hamarituc/poly880-ng/original/schaltung/addr.kicad_sch

## KiCad design original/schaltung/addr.kicad_sch (2026-01-04)

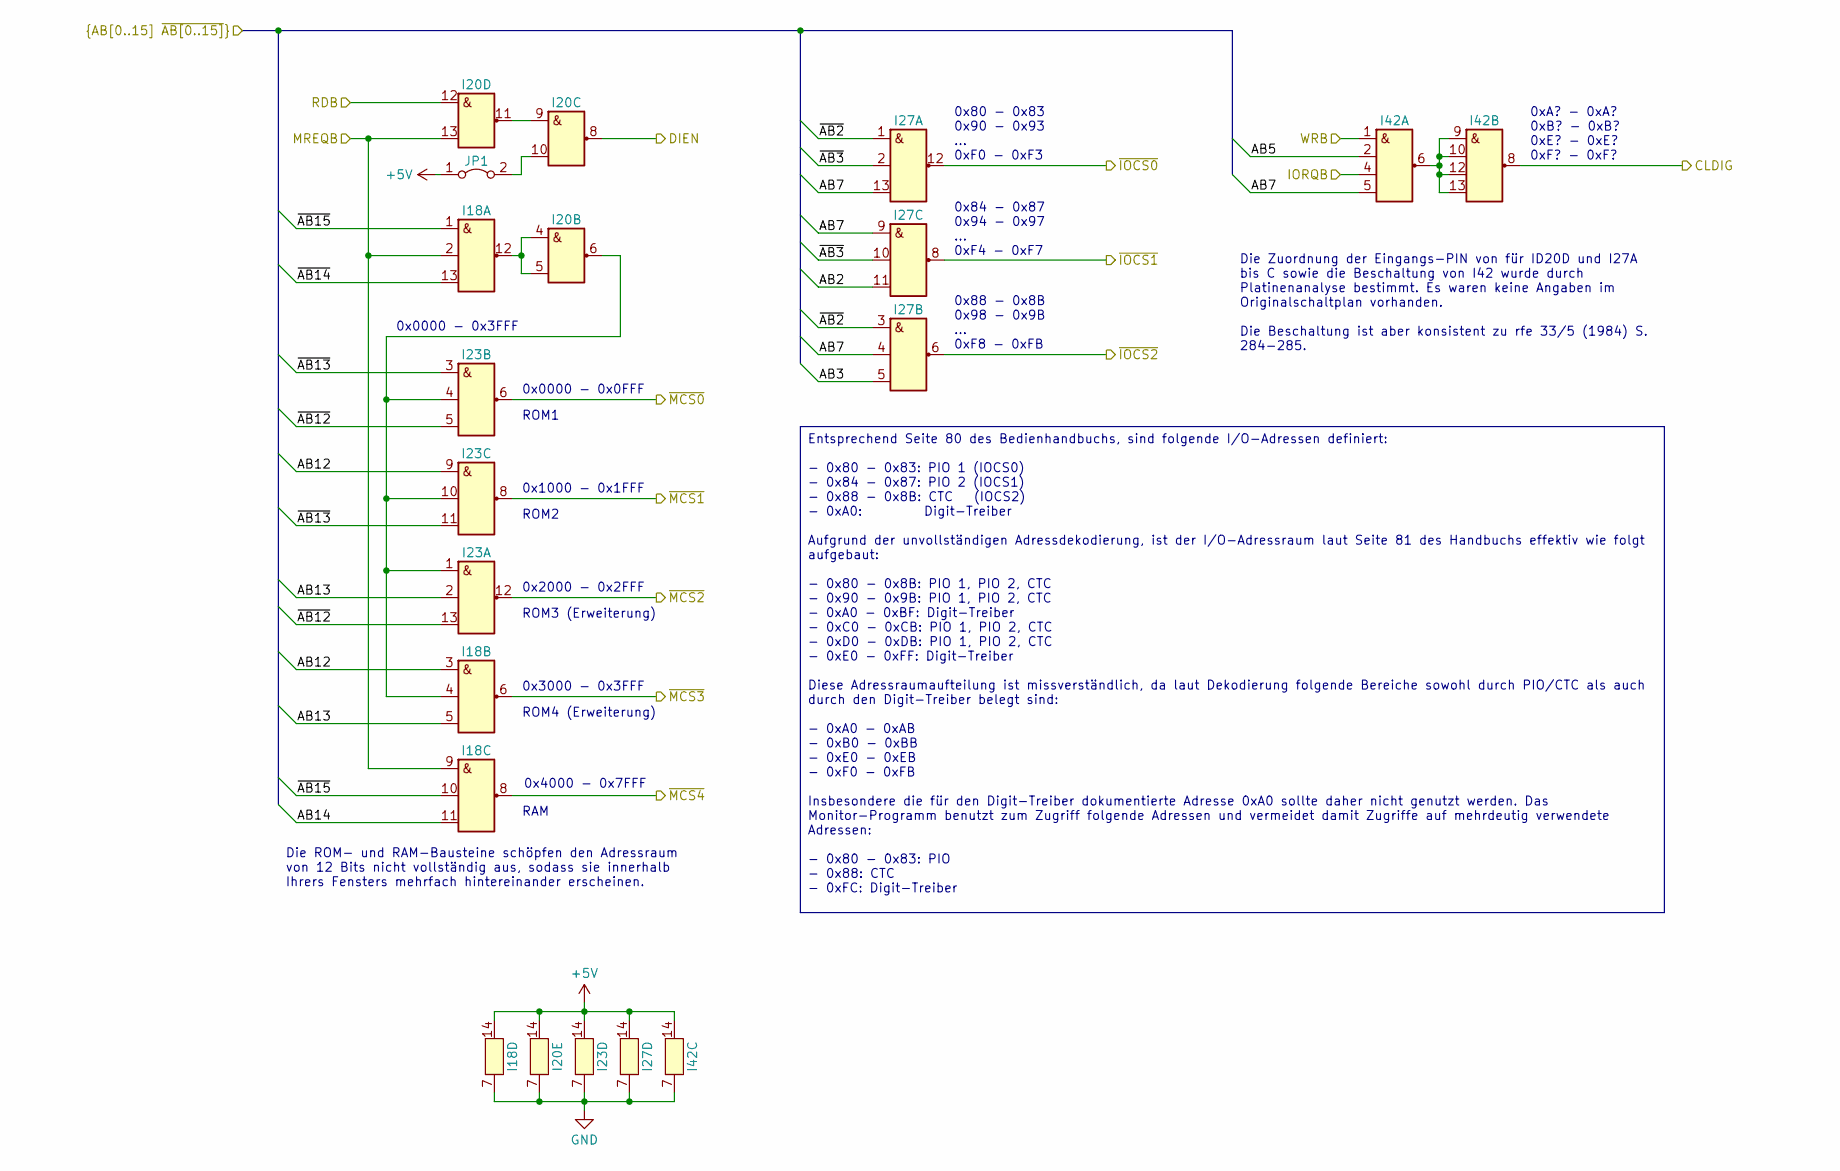
[picture p1: schematic addr.kicad_sch]

Parts:
I18, I23, I27: D110D
I20: D100D
I42: D120D
JP1: Jumper_2_Bridged

Connections:
+5V: I18.14 (Vcc), I20.14 (Vcc), I23.14 (Vcc), I27.14 (Vcc), I42.14 (Vcc), JP1.1 (A)
AB2: I27.11 (C3)
AB3: I27.5 (C2)
AB5: I42.2 (B1)
AB7: I27.4 (B2), I27.9 (A3), I27.13 (C1), I42.5 (D1)
AB12: I18.3 (A2), I23.9 (A3)
AB13: I18.5 (C2), I23.2 (B1)
AB14: I18.11 (C3)
CLDIG: I42.8 (Y2)
DIEN: I20.8 (Y3)
GND: I18.7 (GND), I20.7 (GND), I23.7 (GND), I27.7 (GND), I42.7 (GND)
IORQB: I42.4 (C1)
MREQB: I18.2 (B1), I18.9 (A3), I20.13 (B4)
unnamed: I18.4 (B2), I20.6 (Y2), I23.1 (A1), I23.4 (B2), I23.10 (B3)
unnamed: I18.12 (Y1), I20.4 (A2), I20.5 (B2)
unnamed: I20.10 (B3), JP1.2 (B)
unnamed: I20.9 (A3), I20.11 (Y4)
unnamed: I42.6 (Y1), I42.9 (A2), I42.10 (B2), I42.12 (C2), I42.13 (D2)
RDB: I20.12 (A4)
WRB: I42.1 (A1)
~AB2: I27.1 (A1), I27.3 (A2)
~AB3: I27.2 (B1), I27.10 (B3)
~AB12: I23.5 (C2), I23.13 (C1)
~AB13: I23.3 (A2), I23.11 (C3)
~AB14: I18.13 (C1)
~AB15: I18.1 (A1), I18.10 (B3)
~IOCS0: I27.12 (Y1)
~IOCS1: I27.8 (Y3)
~IOCS2: I27.6 (Y2)
~MCS0: I23.6 (Y2)
~MCS1: I23.8 (Y3)
~MCS2: I23.12 (Y1)
~MCS3: I18.6 (Y2)
~MCS4: I18.8 (Y3)

Notes on the sheet:
0x0000 - 0x3FFF
0x0000 - 0x0FFF
ROM4 (Erweiterung)
0x84 - 0x87 0x94 - 0x97 ... 0xF4 - 0xF7
0x2000 - 0x2FFF
0x1000 - 0x1FFF
ROM1
0x3000 - 0x3FFF
RAM
ROM3 (Erweiterung)
0xA? - 0xA? 0xB? - 0xB? 0xE? - 0xE? 0xF? - 0xF?
0x80 - 0x83 0x90 - 0x93 ... 0xF0 - 0xF3
0x88 - 0x8B 0x98 - 0x9B ... 0xF8 - 0xFB
ROM2
0x4000 - 0x7FFF
Die Zuordnung der Eingangs-PIN von für ID20D und I27A bis C sowie die Beschaltung von I42 wurde durch Platinenanalyse bestimmt. Es waren keine Angaben im Originalschaltplan vorhanden. Die Beschaltung ist aber konsistent zu rfe 33/5 (1984) S. 284-285.
Entsprechend Seite 80 des Bedienhandbuchs, sind folgende I/O-Adressen definiert: - 0x80 - 0x83: PIO 1 (IOCS0) - 0x84 - 0x87: PIO 2 (IOCS1) - 0x88 - 0x8B: CTC (IOCS2) - 0xA0: Digit-Treiber Aufgrund der unvollständigen Adressdekodierung, ist der I/O-Adressraum laut Seite 81 des Handbuchs effektiv wie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
Die ROM- und RAM-Bausteine schöpfen den Adressraum von 12 Bits nicht vollständig aus, sodass sie innerhalb Ihrers Fensters mehrfach hintereinander erscheinen.
