hamarituc/poly880-ng/original/schaltung/bus.kicad_sch

## KiCad design original/schaltung/bus.kicad_sch (2026-01-04)

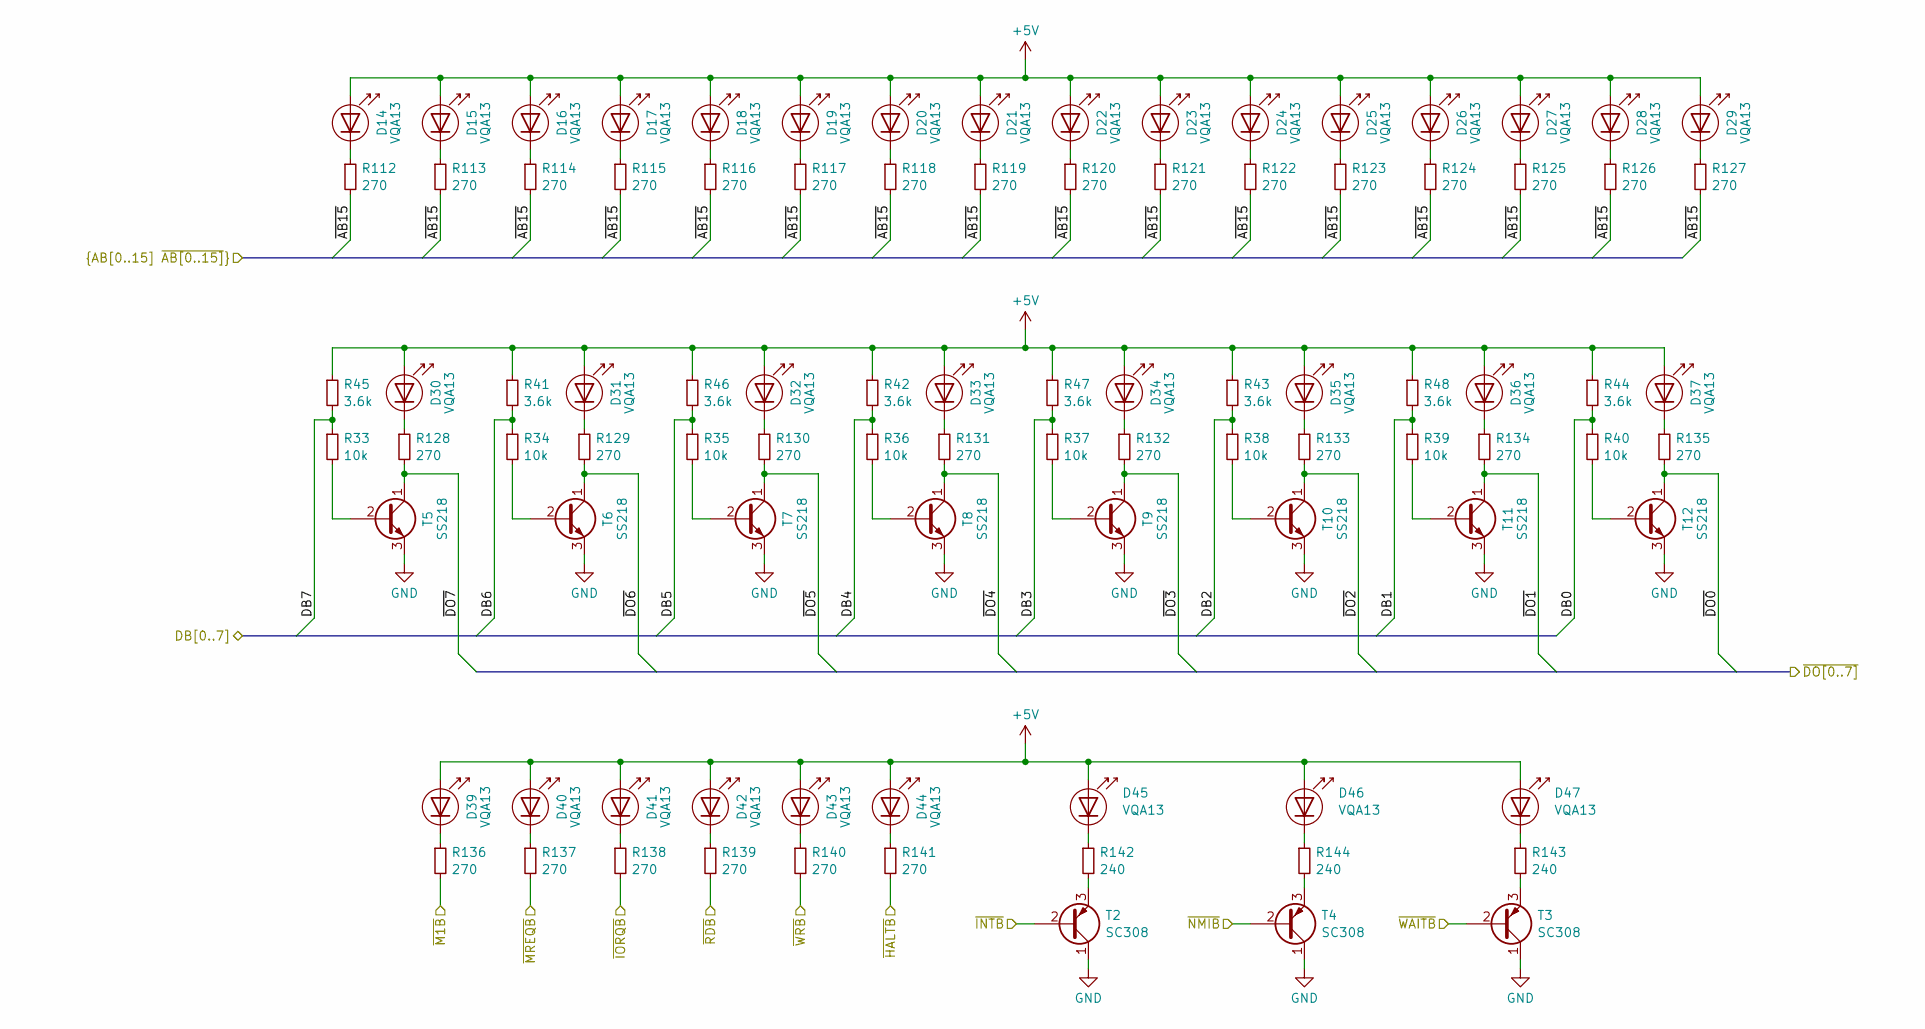
[picture p2: schematic bus.kicad_sch]

Parts:
D14, D15, D16, D17, D18, D19, D20, D21, D22, D23, D24, D25, D26, D27, D28, D29, D30, D31, D32, D33, D34, D35, D36, D37, D39, D40, D41, D42, D43, D44, D45, D46, D47: VQA13
R33, R34, R35, R36, R37, R38, R39, R40: 10k
R41, R42, R43, R44, R45, R46, R47, R48: 3.6k
R112, R113, R114, R115, R116, R117, R118, R119, R120, R121, R122, R123, R124, R125, R126, R127, R128, R129, R130, R131, R132, R133, R134, R135, R136, R137, R138, R139, R140, R141: 270
R142, R143, R144: 240
T2, T3, T4: SC308; T_E-Line_P2.5mm_Vertical
T5, T6, T7, T8, T9, T10, T11, T12: SS218; T_E-Line_P2.5mm_Vertical

Connections:
+5V: D14.2 (A), D15.2 (A), D16.2 (A), D17.2 (A), D18.2 (A), D19.2 (A), D20.2 (A), D21.2 (A), D22.2 (A), D23.2 (A), D24.2 (A), D25.2 (A), D26.2 (A), D27.2 (A), D28.2 (A), D29.2 (A), D30.2 (A), D31.2 (A), D32.2 (A), D33.2 (A), D34.2 (A), D35.2 (A), D36.2 (A), D37.2 (A), D39.2 (A), D40.2 (A), D41.2 (A), D42.2 (A), D43.2 (A), D44.2 (A), D45.2 (A), D46.2 (A), D47.2 (A), R41.1, R42.1, R43.1, R44.1, R45.1, R46.1, R47.1, R48.1
DB0: R40.1, R44.2
DB1: R39.1, R48.2
DB2: R38.1, R43.2
DB3: R37.1, R47.2
DB4: R36.1, R42.2
DB5: R35.1, R46.2
DB6: R34.1, R41.2
DB7: R33.1, R45.2
GND: T2.1 (C), T3.1 (C), T4.1 (C), T5.3 (E), T6.3 (E), T7.3 (E), T8.3 (E), T9.3 (E), T10.3 (E), T11.3 (E), T12.3 (E)
unnamed: D14.1 (K), R112.1
unnamed: D15.1 (K), R113.1
unnamed: D16.1 (K), R114.1
unnamed: D17.1 (K), R115.1
unnamed: D18.1 (K), R116.1
unnamed: D19.1 (K), R117.1
unnamed: D20.1 (K), R118.1
unnamed: D21.1 (K), R119.1
unnamed: D22.1 (K), R120.1
unnamed: D23.1 (K), R121.1
unnamed: D24.1 (K), R122.1
unnamed: D25.1 (K), R123.1
unnamed: D26.1 (K), R124.1
unnamed: D27.1 (K), R125.1
unnamed: D28.1 (K), R126.1
unnamed: D29.1 (K), R127.1
unnamed: D30.1 (K), R128.1
unnamed: D31.1 (K), R129.1
unnamed: D32.1 (K), R130.1
unnamed: D33.1 (K), R131.1
unnamed: D34.1 (K), R132.1
unnamed: D35.1 (K), R133.1
unnamed: D36.1 (K), R134.1
unnamed: D37.1 (K), R135.1
unnamed: D39.1 (K), R136.1
unnamed: D40.1 (K), R137.1
unnamed: D41.1 (K), R138.1
unnamed: D42.1 (K), R139.1
unnamed: D43.1 (K), R140.1
unnamed: D44.1 (K), R141.1
unnamed: D45.1 (K), R142.1
unnamed: D46.1 (K), R144.1
unnamed: D47.1 (K), R143.1
unnamed: R33.2, T5.2 (B)
unnamed: R34.2, T6.2 (B)
unnamed: R35.2, T7.2 (B)
unnamed: R36.2, T8.2 (B)
unnamed: R37.2, T9.2 (B)
unnamed: R38.2, T10.2 (B)
unnamed: R39.2, T11.2 (B)
unnamed: R40.2, T12.2 (B)
unnamed: R142.2, T2.3 (E)
unnamed: R143.2, T3.3 (E)
unnamed: R144.2, T4.3 (E)
~AB15: R112.2, R113.2, R114.2, R115.2, R116.2, R117.2, R118.2, R119.2, R120.2, R121.2, R122.2, R123.2, R124.2, R125.2, R126.2, R127.2
~DO0: R135.2, T12.1 (C)
~DO1: R134.2, T11.1 (C)
~DO2: R133.2, T10.1 (C)
~DO3: R132.2, T9.1 (C)
~DO4: R131.2, T8.1 (C)
~DO5: R130.2, T7.1 (C)
~DO6: R129.2, T6.1 (C)
~DO7: R128.2, T5.1 (C)
~HALTB: R141.2
~INTB: T2.2 (B)
~IORQB: R138.2
~M1B: R136.2
~MREQB: R137.2
~NMIB: T4.2 (B)
~RDB: R139.2
~WAITB: T3.2 (B)
~WRB: R140.2
