hamarituc/poly880-ng/original/schaltung/clock.kicad_sch

## KiCad design original/schaltung/clock.kicad_sch (2026-01-04)

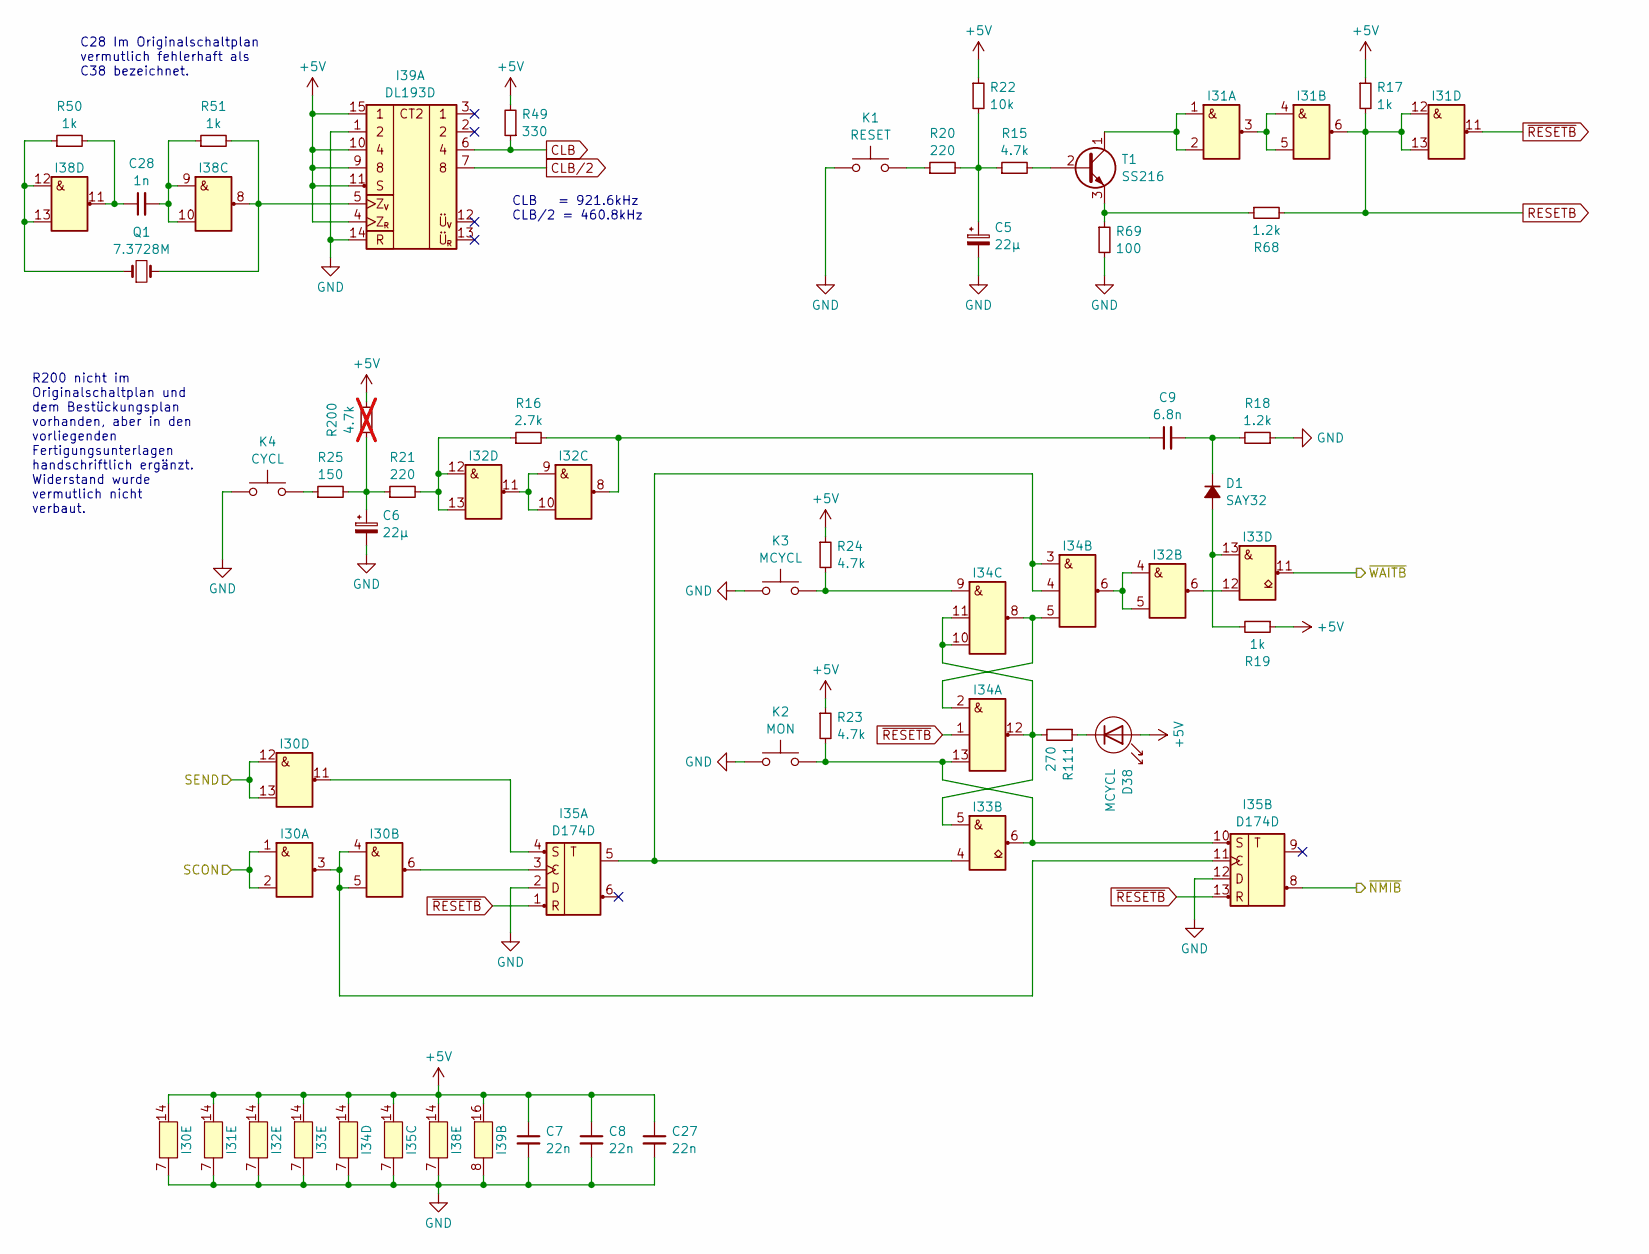
[picture p3: schematic clock.kicad_sch]

Parts:
C5, C6: 22µ
C7, C8, C27: 22n
C9: 6.8n
C28: 1n
D1: SAY32; D_E-Line_01x02_P2.5mm_Vertical_KA
D38: MCYCL
I30, I31, I32, I38: D100D
I33: D103D
I34: D110D
I35: D174D
I39: DL193D
K1: RESET
K2: MON
K3: MCYCL
K4: CYCL
Q1: 7.3728M
R15, R23, R24: 4.7k
R16: 2.7k
R17, R19, R50, R51: 1k
R18, R68: 1.2k
R20, R21: 220
R22: 10k
R25: 150
R49: 330
R69: 100
R111: 270
R200: 4.7k; not fitted
T1: SS216; T_E-Line_P2.5mm_Vertical

Connections:
+5V: C7.1, C8.1, C27.1, D38.2 (A), I30.14 (Vcc), I31.14 (Vcc), I32.14 (Vcc), I33.14 (Vcc), I34.14 (Vcc), I35.14 (Vcc), I38.14 (Vcc), I39.4 (TR), I39.9 (D), I39.10 (C), I39.11 (S), I39.15 (A), I39.16 (Vcc), R17.1, R19.1, R22.1, R23.1, R24.1, R49.2, R200.2
CLB: I39.6 (QC), R49.1
CLB/2: I39.7 (QD)
GND: C5.2, C6.2, C7.2, C8.2, C27.2, I30.7 (GND), I31.7 (GND), I32.7 (GND), I33.7 (GND), I34.7 (GND), I35.2 (D1), I35.7 (GND), I35.12 (D2), I38.7 (GND), I39.1 (B), I39.8 (GND), I39.14 (R), K1.1, K2.1, K3.1, K4.1, R18.1, R69.2
unnamed: C5.1, R15.1, R20.2, R22.2
unnamed: C6.1, R21.1, R25.2, R200.1
unnamed: C9.1, I32.8 (Y3), R16.2
unnamed: C9.2, D1.1 (K), R18.2
unnamed: C28.1, I38.11 (Y4), R50.2
unnamed: C28.2, I38.9 (A3), I38.10 (B3), R51.1
unnamed: D1.2 (A), I33.13 (B4), R19.2
unnamed: D38.1 (K), R111.1
unnamed: I30.3 (Y1), I30.4 (A2), I30.5 (B2), I35.11 (T2)
unnamed: I30.6 (Y2), I35.3 (T1)
unnamed: I30.11 (Y4), I35.4 (S1)
unnamed: I31.1 (A1), I31.2 (B1), T1.1 (C)
unnamed: I31.3 (Y1), I31.4 (A2), I31.5 (B2)
unnamed: I32.4 (A2), I32.5 (B2), I34.6 (Y2)
unnamed: I32.6 (Y2), I33.12 (A4)
unnamed: I32.9 (A3), I32.10 (B3), I32.11 (Y4)
unnamed: I32.12 (A4), I32.13 (B4), R16.1, R21.2
unnamed: I33.4 (A2), I34.3 (A2), I34.4 (B2), I35.5 (Q1)
unnamed: I33.5 (B2), I34.10 (B3), I34.11 (C3), I34.12 (Y1), R111.2
unnamed: I33.6 (Y2), I34.13 (C1), I35.10 (S2), K2.2, R23.2
unnamed: I34.2 (B1), I34.5 (C2), I34.8 (Y3)
unnamed: I34.9 (A3), K3.2, R24.2
unnamed: I38.8 (Y3), I39.5 (TV), Q1.2, R51.2
unnamed: I38.12 (A4), I38.13 (B4), Q1.1, R50.1
unnamed: K1.2, R20.1
unnamed: K4.2, R25.1
unnamed: R15.2, T1.2 (B)
unnamed: R68.1, R69.1, T1.3 (E)
RESETB: I31.6 (Y2), I31.12 (A4), I31.13 (B4), R17.2, R68.2
SCON: I30.1 (A1), I30.2 (B1)
SEND: I30.12 (A4), I30.13 (B4)
~NMIB: I35.8 (/Q2)
~RESETB: I31.11 (Y4), I34.1 (A1), I35.1 (R1), I35.13 (R2)
~WAITB: I33.11 (Y4)

Notes on the sheet:
C28 Im Originalschaltplan vermutlich fehlerhaft als C38 bezeichnet.
CLB = 921.6kHz CLB/2 = 460.8kHz
R200 nicht im Originalschaltplan und dem Bestückungsplan vorhanden, aber in den vorliegenden Fertigungsunterlagen handschriftlich ergänzt. Widerstand wurde vermutlich nicht verbaut.
