hamarituc/poly880-ng/original/schaltung/cpu.kicad_sch

## KiCad design original/schaltung/cpu.kicad_sch (2026-01-04)

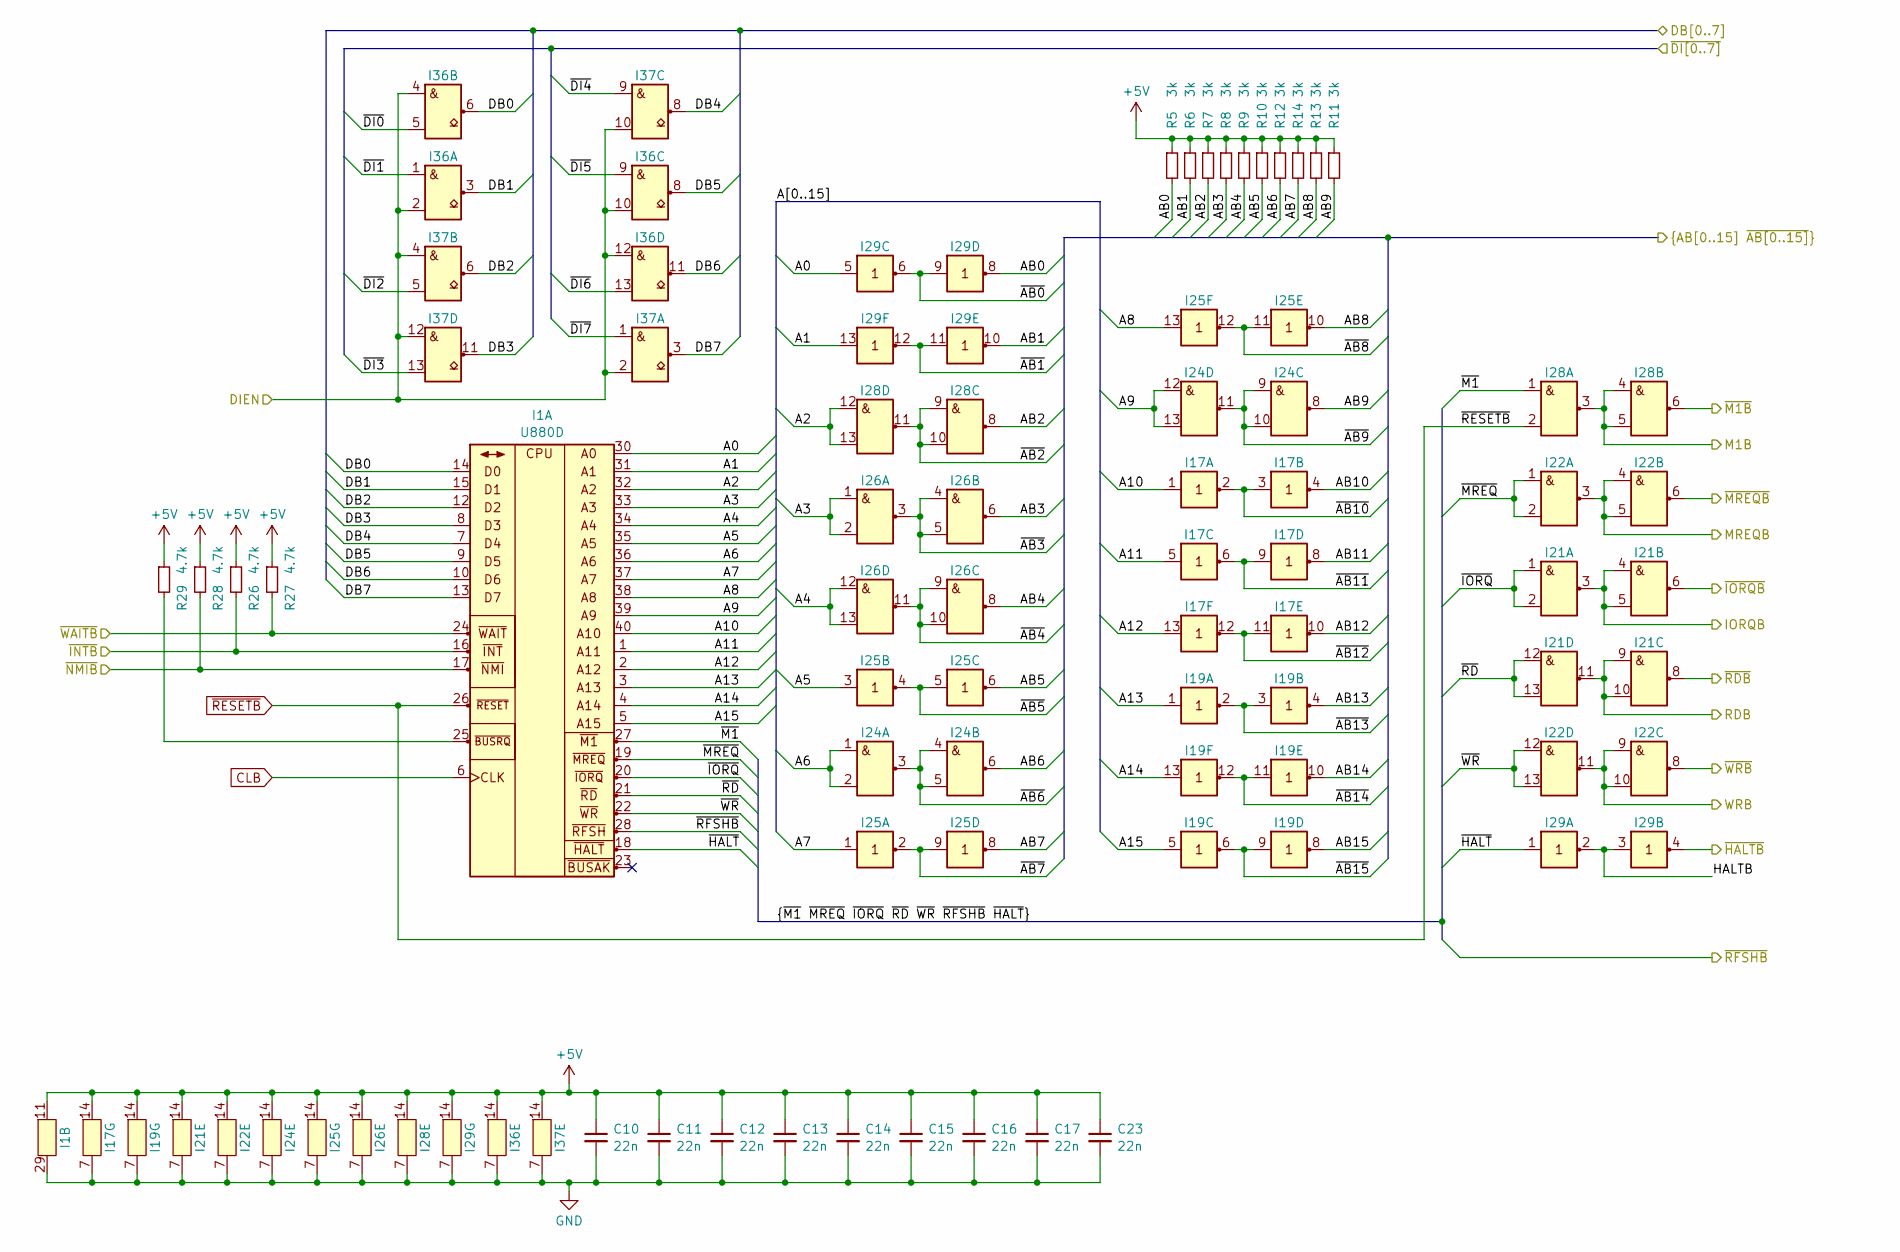
[picture p4: schematic cpu.kicad_sch]

Parts:
C10, C11, C12, C13, C14, C15, C16, C17, C23: 22n
I1: U880D
I17, I19, I25, I29: D104D
I21, I22, I24, I26, I28: D100D
I36, I37: D103D
R5, R6, R7, R8, R9, R10, R11, R12, R13, R14: 3k
R26, R27, R28, R29: 4.7k

Connections:
+5V: C10.1, C11.1, C12.1, C13.1, C14.1, C15.1, C16.1, C17.1, C23.1, I1.11 (Vcc), I17.14 (Vcc), I19.14 (Vcc), I21.14 (Vcc), I22.14 (Vcc), I24.14 (Vcc), I25.14 (Vcc), I26.14 (Vcc), I28.14 (Vcc), I29.14 (Vcc), I36.14 (Vcc), I37.14 (Vcc), R5.1, R6.1, R7.1, R8.1, R9.1, R10.1, R11.1, R12.1, R13.1, R14.1, R26.1, R27.1, R28.1, R29.1
A0: I1.30 (A0), I29.5 (A3)
A1: I1.31 (A1), I29.13 (A6)
A2: I1.32 (A2), I28.12 (A4), I28.13 (B4)
A3: I1.33 (A3), I26.1 (A1), I26.2 (B1)
A4: I1.34 (A4), I26.12 (A4), I26.13 (B4)
A5: I1.35 (A5), I25.3 (A2)
A6: I1.36 (A6), I24.1 (A1), I24.2 (B1)
A7: I1.37 (A7), I25.1 (A1)
A8: I1.38 (A8), I25.13 (A6)
A9: I1.39 (A9), I24.12 (A4), I24.13 (B4)
A10: I1.40 (A10), I17.1 (A1)
A11: I1.1 (A11), I17.5 (A3)
A12: I1.2 (A12), I17.13 (A6)
A13: I1.3 (A13), I19.1 (A1)
A14: I1.4 (A14), I19.13 (A6)
A15: I1.5 (A15), I19.5 (A3)
AB0: I29.8 (Y4), R5.2
AB1: I29.10 (Y5), R6.2
AB2: I28.8 (Y3), R7.2
AB3: I26.6 (Y2), R8.2
AB4: I26.8 (Y3), R9.2
AB5: I25.6 (Y3), R10.2
AB6: I24.6 (Y2), R12.2
AB7: I25.8 (Y4), R14.2
AB8: I25.10 (Y5), R13.2
AB9: I24.8 (Y3), R11.2
AB10: I17.4 (Y2)
AB11: I17.8 (Y4)
AB12: I17.10 (Y5)
AB13: I19.4 (Y2)
AB14: I19.10 (Y5)
AB15: I19.8 (Y4)
CLB: I1.6 (CLK)
DB0: I1.14 (D0), I36.6 (Y2)
DB1: I1.15 (D1), I36.3 (Y1)
DB2: I1.12 (D2), I37.6 (Y2)
DB3: I1.8 (D3), I37.11 (Y4)
DB4: I1.7 (D4), I37.8 (Y3)
DB5: I1.9 (D5), I36.8 (Y3)
DB6: I1.10 (D6), I36.11 (Y4)
DB7: I1.13 (D7), I37.3 (Y1)
DIEN: I36.2 (B1), I36.4 (A2), I36.10 (B3), I36.12 (A4), I37.2 (B1), I37.4 (A2), I37.10 (B3), I37.12 (A4)
GND: C10.2, C11.2, C12.2, C13.2, C14.2, C15.2, C16.2, C17.2, C23.2, I1.29 (GND), I17.7 (GND), I19.7 (GND), I21.7 (GND), I22.7 (GND), I24.7 (GND), I25.7 (GND), I26.7 (GND), I28.7 (GND), I29.7 (GND), I36.7 (GND), I37.7 (GND)
HALTB: I29.2 (Y1), I29.3 (A2)
IORQB: I21.3 (Y1), I21.4 (A2), I21.5 (B2)
M1B: I28.3 (Y1), I28.4 (A2), I28.5 (B2)
MREQB: I22.3 (Y1), I22.4 (A2), I22.5 (B2)
unnamed: I1.25 (~BUSRQ), R29.2
RDB: I21.9 (A3), I21.10 (B3), I21.11 (Y4)
WRB: I22.9 (A3), I22.10 (B3), I22.11 (Y4)
~AB0: I29.6 (Y3), I29.9 (A4)
~AB1: I29.11 (A5), I29.12 (Y6)
~AB2: I28.9 (A3), I28.10 (B3), I28.11 (Y4)
~AB3: I26.3 (Y1), I26.4 (A2), I26.5 (B2)
~AB4: I26.9 (A3), I26.10 (B3), I26.11 (Y4)
~AB5: I25.4 (Y2), I25.5 (A3)
~AB6: I24.3 (Y1), I24.4 (A2), I24.5 (B2)
~AB7: I25.2 (Y1), I25.9 (A4)
~AB8: I25.11 (A5), I25.12 (Y6)
~AB9: I24.9 (A3), I24.10 (B3), I24.11 (Y4)
~AB10: I17.2 (Y1), I17.3 (A2)
~AB11: I17.6 (Y3), I17.9 (A4)
~AB12: I17.11 (A5), I17.12 (Y6)
~AB13: I19.2 (Y1), I19.3 (A2)
~AB14: I19.11 (A5), I19.12 (Y6)
~AB15: I19.6 (Y3), I19.9 (A4)
~DI0: I36.5 (B2)
~DI1: I36.1 (A1)
~DI2: I37.5 (B2)
~DI3: I37.13 (B4)
~DI4: I37.9 (A3)
~DI5: I36.9 (A3)
~DI6: I36.13 (B4)
~DI7: I37.1 (A1)
~HALTB: I29.4 (Y2)
~HALT: I1.18 (~HALT), I29.1 (A1)
~INTB: I1.16 (~INT), R26.2
~IORQB: I21.6 (Y2)
~IORQ: I1.20 (~IORQ), I21.1 (A1), I21.2 (B1)
~M1B: I28.6 (Y2)
~M1: I1.27 (~M1), I28.1 (A1)
~MREQB: I22.6 (Y2)
~MREQ: I1.19 (~MREQ), I22.1 (A1), I22.2 (B1)
~NMIB: I1.17 (~NMI), R28.2
~RDB: I21.8 (Y3)
~RD: I1.21 (~RD), I21.12 (A4), I21.13 (B4)
~RESETB: I1.26 (~RESET), I28.2 (B1)
~RFSHB: I1.28 (~RFSH)
~WAITB: I1.24 (~WAIT), R27.2
~WRB: I22.8 (Y3)
~WR: I1.22 (~WR), I22.12 (A4), I22.13 (B4)
