hamarituc/poly880-ng/original/schaltung/disp.kicad_sch

## KiCad design original/schaltung/disp.kicad_sch (2026-01-04)

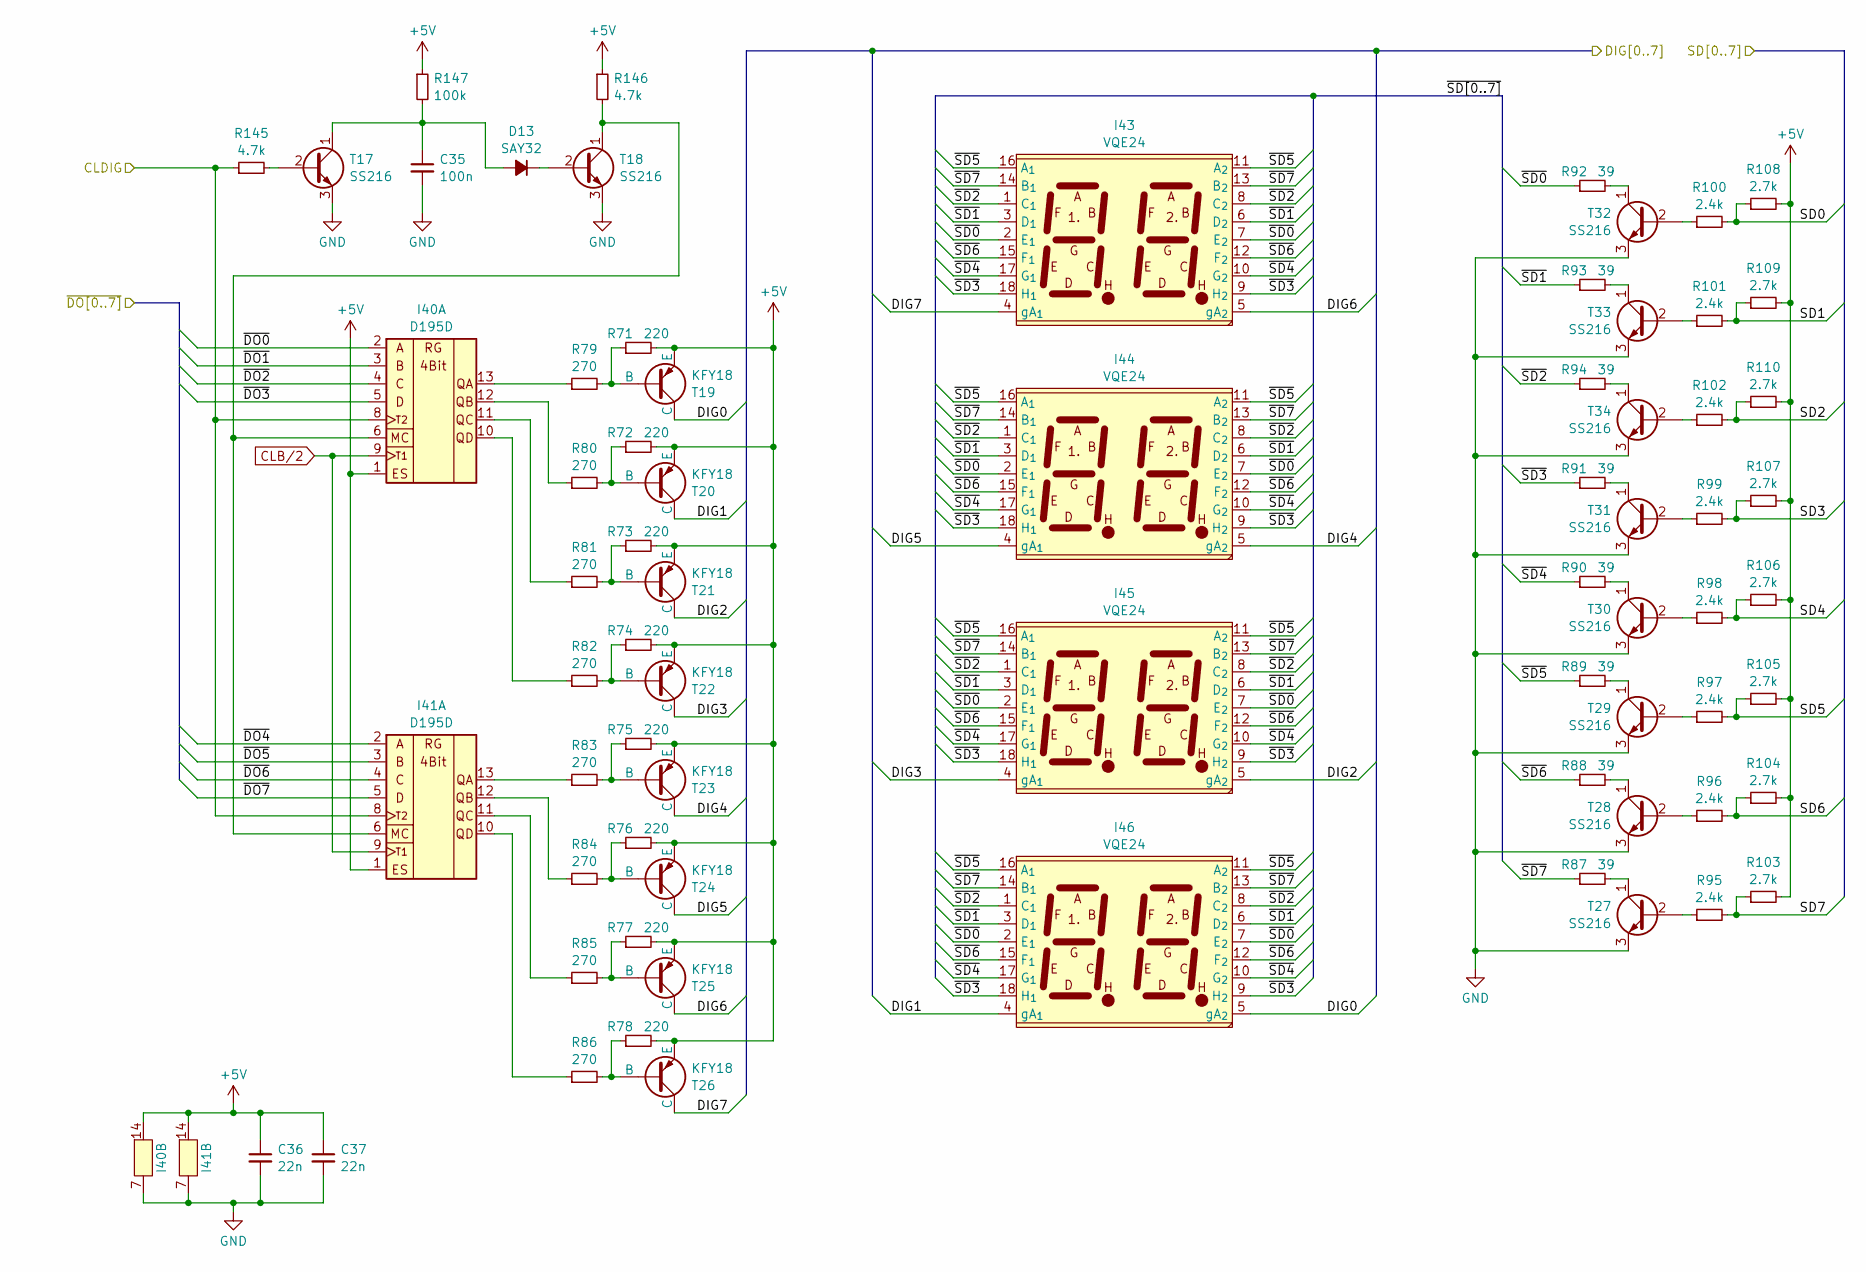
[picture p5: schematic disp.kicad_sch]

Parts:
C35: 100n
C36, C37: 22n
D13: SAY32; D_E-Line_01x02_P2.5mm_Vertical_KA
I40, I41: D195D
I43, I44, I45, I46: VQE24
R71, R72, R73, R74, R75, R76, R77, R78: 220
R79, R80, R81, R82, R83, R84, R85, R86: 270
R87, R88, R89, R90, R91, R92, R93, R94: 39
R95, R96, R97, R98, R99, R100, R101, R102: 2.4k
R103, R104, R105, R106, R107, R108, R109, R110: 2.7k
R145, R146: 4.7k
R147: 100k
T17, T18, T27, T28, T29, T30, T31, T32, T33, T34: SS216; T_E-Line_P2.5mm_Vertical
T19, T20, T21, T22, T23, T24, T25, T26: KFY18

Connections:
+5V: C36.1, C37.1, I40.1 (ES), I40.14 (Vcc), I41.1 (ES), I41.14 (Vcc), R71.2, R72.2, R73.2, R74.2, R75.2, R76.2, R77.2, R78.2, R103.2, R104.2, R105.2, R106.2, R107.2, R108.2, R109.2, R110.2, R146.1, R147.1, T19.3 (E), T20.3 (E), T21.3 (E), T22.3 (E), T23.3 (E), T24.3 (E), T25.3 (E), T26.3 (E)
CLB/2: I40.9 (T1), I41.9 (T1)
CLDIG: I40.8 (T2), I41.8 (T2), R145.1
DIG0: I46.5 (gA_{2}), T19.1 (C)
DIG1: I46.4 (gA_{1}), T20.1 (C)
DIG2: I45.5 (gA_{2}), T21.1 (C)
DIG3: I45.4 (gA_{1}), T22.1 (C)
DIG4: I44.5 (gA_{2}), T23.1 (C)
DIG5: I44.4 (gA_{1}), T24.1 (C)
DIG6: I43.5 (gA_{2}), T25.1 (C)
DIG7: I43.4 (gA_{1}), T26.1 (C)
GND: C35.2, C36.2, C37.2, I40.7 (GND), I41.7 (GND), T17.3 (E), T18.3 (E), T27.3 (E), T28.3 (E), T29.3 (E), T30.3 (E), T31.3 (E), T32.3 (E), T33.3 (E), T34.3 (E)
unnamed: C35.1, D13.2 (A), R147.2, T17.1 (C)
unnamed: D13.1 (K), T18.2 (B)
unnamed: I40.6 (MC), I41.6 (MC), R146.2, T18.1 (C)
unnamed: I40.10 (QD), R82.1
unnamed: I40.11 (QC), R81.1
unnamed: I40.12 (QB), R80.1
unnamed: I40.13 (QA), R79.1
unnamed: I41.10 (QD), R86.1
unnamed: I41.11 (QC), R85.1
unnamed: I41.12 (QB), R84.1
unnamed: I41.13 (QA), R83.1
unnamed: R71.1, R79.2, T19.2 (B)
unnamed: R72.1, R80.2, T20.2 (B)
unnamed: R73.1, R81.2, T21.2 (B)
unnamed: R74.1, R82.2, T22.2 (B)
unnamed: R75.1, R83.2, T23.2 (B)
unnamed: R76.1, R84.2, T24.2 (B)
unnamed: R77.1, R85.2, T25.2 (B)
unnamed: R78.1, R86.2, T26.2 (B)
unnamed: R87.2, T27.1 (C)
unnamed: R88.2, T28.1 (C)
unnamed: R89.2, T29.1 (C)
unnamed: R90.2, T30.1 (C)
unnamed: R91.2, T31.1 (C)
unnamed: R92.2, T32.1 (C)
unnamed: R93.2, T33.1 (C)
unnamed: R94.2, T34.1 (C)
unnamed: R95.1, T27.2 (B)
unnamed: R96.1, T28.2 (B)
unnamed: R97.1, T29.2 (B)
unnamed: R98.1, T30.2 (B)
unnamed: R99.1, T31.2 (B)
unnamed: R100.1, T32.2 (B)
unnamed: R101.1, T33.2 (B)
unnamed: R102.1, T34.2 (B)
unnamed: R145.2, T17.2 (B)
SD0: R100.2, R108.1
SD1: R101.2, R109.1
SD2: R102.2, R110.1
SD3: R99.2, R107.1
SD4: R98.2, R106.1
SD5: R97.2, R105.1
SD6: R96.2, R104.1
SD7: R95.2, R103.1
~DO0: I40.2 (A)
~DO1: I40.3 (B)
~DO2: I40.4 (C)
~DO3: I40.5 (D)
~DO4: I41.2 (A)
~DO5: I41.3 (B)
~DO6: I41.4 (C)
~DO7: I41.5 (D)
~SD0: I43.2 (E_{1}), I43.7 (E_{2}), I44.2 (E_{1}), I44.7 (E_{2}), I45.2 (E_{1}), I45.7 (E_{2}), I46.2 (E_{1}), I46.7 (E_{2}), R92.1
~SD1: I43.3 (D_{1}), I43.6 (D_{2}), I44.3 (D_{1}), I44.6 (D_{2}), I45.3 (D_{1}), I45.6 (D_{2}), I46.3 (D_{1}), I46.6 (D_{2}), R93.1
~SD2: I43.1 (C_{1}), I43.8 (C_{2}), I44.1 (C_{1}), I44.8 (C_{2}), I45.1 (C_{1}), I45.8 (C_{2}), I46.1 (C_{1}), I46.8 (C_{2}), R94.1
~SD3: I43.9 (H_{2}), I43.18 (H_{1}), I44.9 (H_{2}), I44.18 (H_{1}), I45.9 (H_{2}), I45.18 (H_{1}), I46.9 (H_{2}), I46.18 (H_{1}), R91.1
~SD4: I43.10 (G_{2}), I43.17 (G_{1}), I44.10 (G_{2}), I44.17 (G_{1}), I45.10 (G_{2}), I45.17 (G_{1}), I46.10 (G_{2}), I46.17 (G_{1}), R90.1
~SD5: I43.11 (A_{2}), I43.16 (A_{1}), I44.11 (A_{2}), I44.16 (A_{1}), I45.11 (A_{2}), I45.16 (A_{1}), I46.11 (A_{2}), I46.16 (A_{1}), R89.1
~SD6: I43.12 (F_{2}), I43.15 (F_{1}), I44.12 (F_{2}), I44.15 (F_{1}), I45.12 (F_{2}), I45.15 (F_{1}), I46.12 (F_{2}), I46.15 (F_{1}), R88.1
~SD7: I43.13 (B_{2}), I43.14 (B_{1}), I44.13 (B_{2}), I44.14 (B_{1}), I45.13 (B_{2}), I45.14 (B_{1}), I46.13 (B_{2}), I46.14 (B_{1}), R87.1
