hamarituc/poly880-ng/original/schaltung/io.kicad_sch

## KiCad design original/schaltung/io.kicad_sch (2026-01-04)

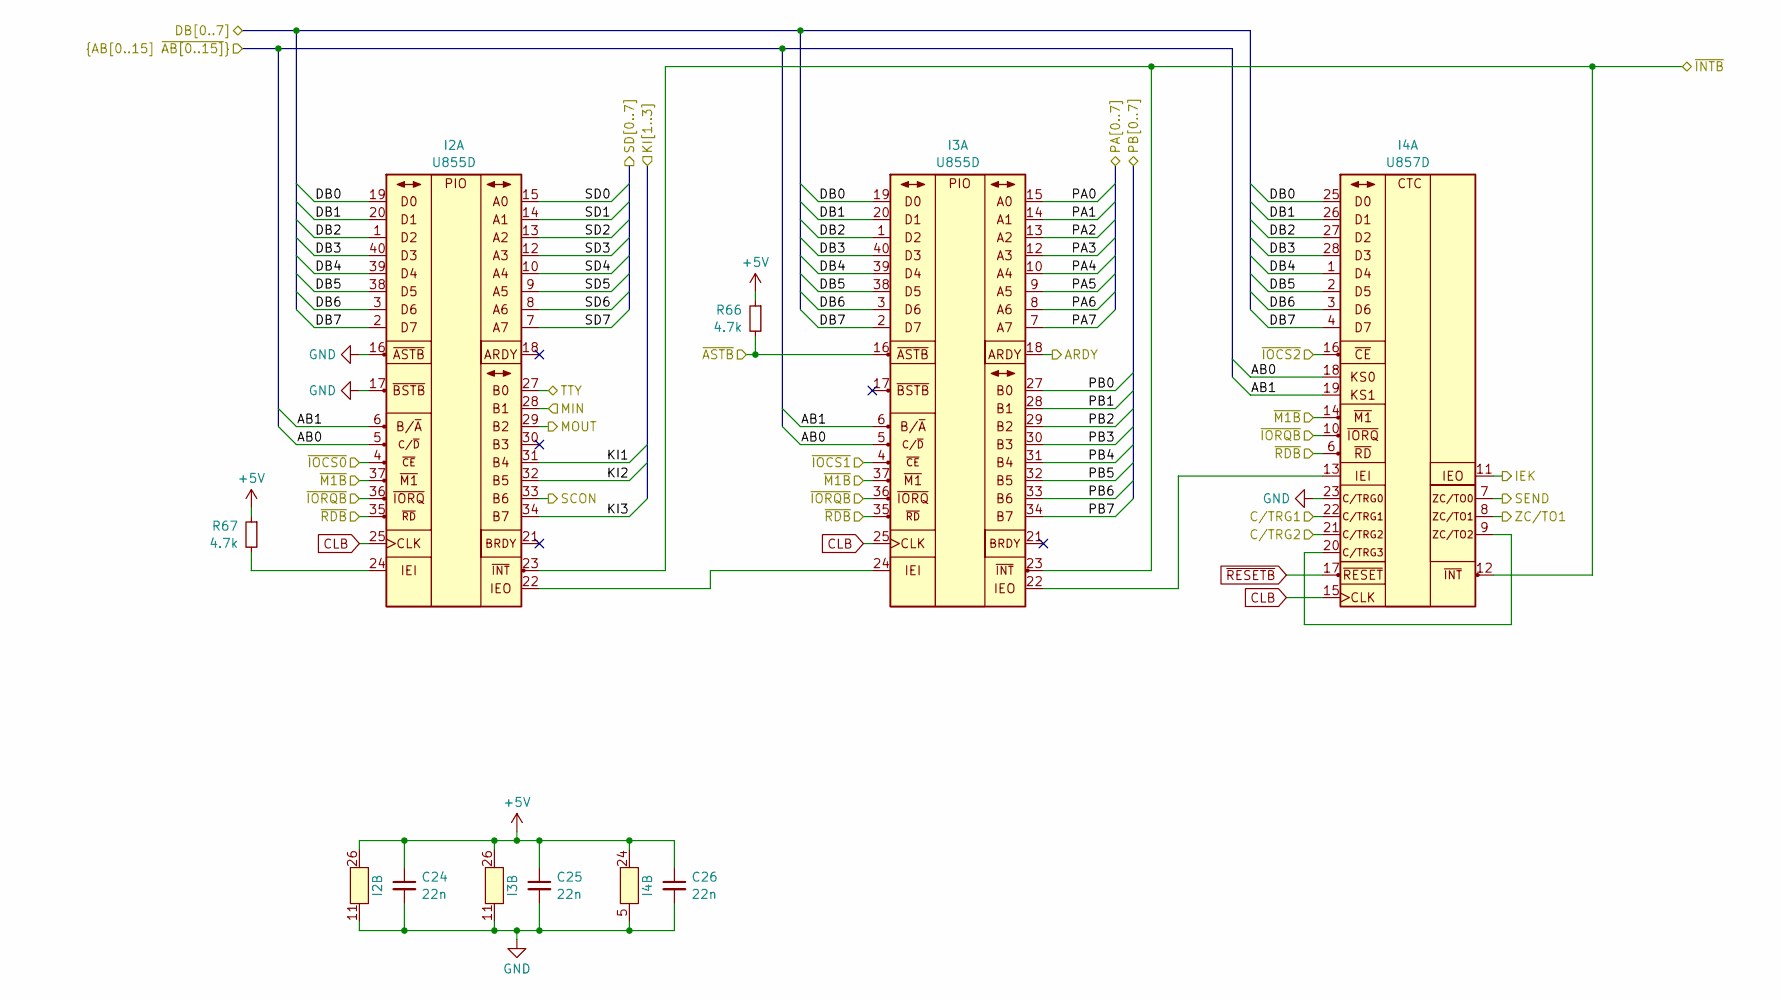
[picture p6: schematic io.kicad_sch]

Parts:
C24, C25, C26: 22n
I2, I3: U855D
I4: U857D
R66, R67: 4.7k

Connections:
+5V: C24.1, C25.1, C26.1, I2.26 (Vcc), I3.26 (Vcc), I4.24 (Vcc), R66.1, R67.1
AB0: I2.5 (C/~D), I3.5 (C/~D), I4.18 (~BSTB)
AB1: I2.6 (B/~A), I3.6 (B/~A), I4.19 (B/~A)
ARDY: I3.18 (ARDY)
CLB: I2.25 (CLK), I3.25 (CLK), I4.15 (CLK)
C/TRG1: I4.22 (~RD)
C/TRG2: I4.21 (~IORQ)
DB0: I2.19 (D0), I3.19 (D0), I4.25 (D0)
DB1: I2.20 (D1), I3.20 (D1), I4.26 (D1)
DB2: I2.1 (D2), I3.1 (D2), I4.27 (D2)
DB3: I2.40 (D3), I3.40 (D3), I4.28 (D3)
DB4: I2.39 (D4), I3.39 (D4), I4.1 (D4)
DB5: I2.38 (D5), I3.38 (D5), I4.2 (D5)
DB6: I2.3 (D6), I3.3 (D6), I4.3 (D6)
DB7: I2.2 (D7), I3.2 (D7), I4.4 (D7)
GND: C24.2, C25.2, C26.2, I2.11 (GND), I2.16 (~ASTB), I2.17 (~BSTB), I3.11 (GND), I4.5 (GND), I4.23 (~IORQ)
IEK: I4.11 (IEO)
KI1: I2.31 (B4)
KI2: I2.32 (B5)
KI3: I2.34 (B7)
MIN: I2.28 (B1)
MOUT: I2.29 (B2)
unnamed: I2.22 (IEO), I3.24 (IEI)
unnamed: I2.24 (IEI), R67.2
unnamed: I3.22 (IEO), I4.13 (IEI)
unnamed: I4.9 (B6), I4.20 (~RD)
PA0: I3.15 (A0)
PA1: I3.14 (A1)
PA2: I3.13 (A2)
PA3: I3.12 (A3)
PA4: I3.10 (A4)
PA5: I3.9 (A5)
PA6: I3.8 (A6)
PA7: I3.7 (A7)
PB0: I3.27 (B0)
PB1: I3.28 (B1)
PB2: I3.29 (B2)
PB3: I3.30 (B3)
PB4: I3.31 (B4)
PB5: I3.32 (B5)
PB6: I3.33 (B6)
PB7: I3.34 (B7)
SCON: I2.33 (B6)
SD0: I2.15 (A0)
SD1: I2.14 (A1)
SD2: I2.13 (A2)
SD3: I2.12 (A3)
SD4: I2.10 (A4)
SD5: I2.9 (A5)
SD6: I2.8 (A6)
SD7: I2.7 (A7)
SEND: I4.7 (B4)
TTY: I2.27 (B0)
ZC/TO1: I4.8 (B5)
~ASTB: I3.16 (~ASTB), R66.2
~INTB: I2.23 (~INT), I3.23 (~INT), I4.12 (~INT)
~IOCS0: I2.4 (~CE)
~IOCS1: I3.4 (~CE)
~IOCS2: I4.16 (~ASTB)
~IORQB: I2.36 (~IORQ), I3.36 (~IORQ), I4.10 (~CE)
~M1B: I2.37 (~M1), I3.37 (~M1), I4.14 (C/~D)
~RDB: I2.35 (~RD), I3.35 (~RD), I4.6 (~M1)
~RESETB: I4.17 (IEI)
