hamarituc/poly880-ng/original/schaltung/keyb.kicad_sch

## KiCad design original/schaltung/keyb.kicad_sch (2026-01-04)

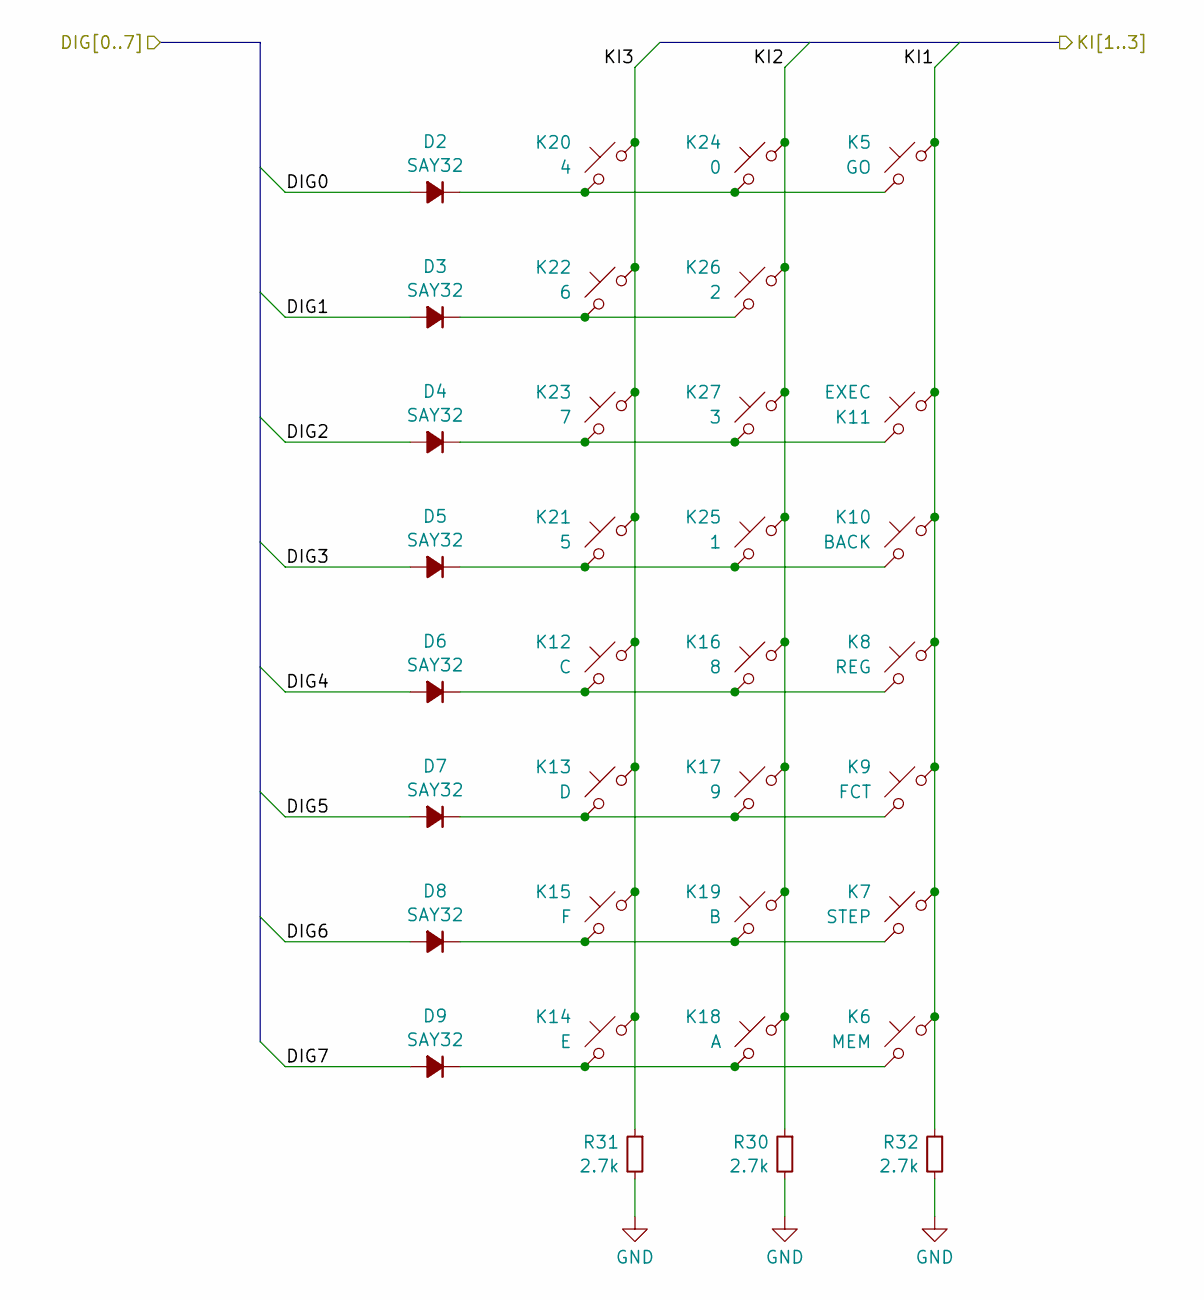
[picture p7: schematic keyb.kicad_sch]

Parts:
D2, D3, D4, D5, D6, D7, D8, D9: SAY32; D_E-Line_01x02_P2.5mm_Vertical_KA
K5: GO
K6: MEM
K7: STEP
K8: REG
K9: FCT
K10: BACK
K11: EXEC
K12: C
K13: D
K14: E
K15: F
K16: 8
K17: 9
K18: A
K19: B
K20: 4
K21: 5
K22: 6
K23: 7
K24: 0
K25: 1
K26: 2
K27: 3
R30, R31, R32: 2.7k

Connections:
DIG0: D2.2 (A)
DIG1: D3.2 (A)
DIG2: D4.2 (A)
DIG3: D5.2 (A)
DIG4: D6.2 (A)
DIG5: D7.2 (A)
DIG6: D8.2 (A)
DIG7: D9.2 (A)
GND: R30.2, R31.2, R32.2
KI1: K5.1, K6.1, K7.1, K8.1, K9.1, K10.1, K11.1, R32.1
KI2: K16.1, K17.1, K18.1, K19.1, K24.1, K25.1, K26.1, K27.1, R30.1
KI3: K12.1, K13.1, K14.1, K15.1, K20.1, K21.1, K22.1, K23.1, R31.1
unnamed: D2.1 (K), K5.2, K20.2, K24.2
unnamed: D3.1 (K), K22.2, K26.2
unnamed: D4.1 (K), K11.2, K23.2, K27.2
unnamed: D5.1 (K), K10.2, K21.2, K25.2
unnamed: D6.1 (K), K8.2, K12.2, K16.2
unnamed: D7.1 (K), K9.2, K13.2, K17.2
unnamed: D8.1 (K), K7.2, K15.2, K19.2
unnamed: D9.1 (K), K6.2, K14.2, K18.2
