hamarituc/poly880-ng/original/schaltung/mem.kicad_sch

## KiCad design original/schaltung/mem.kicad_sch (2026-01-04)

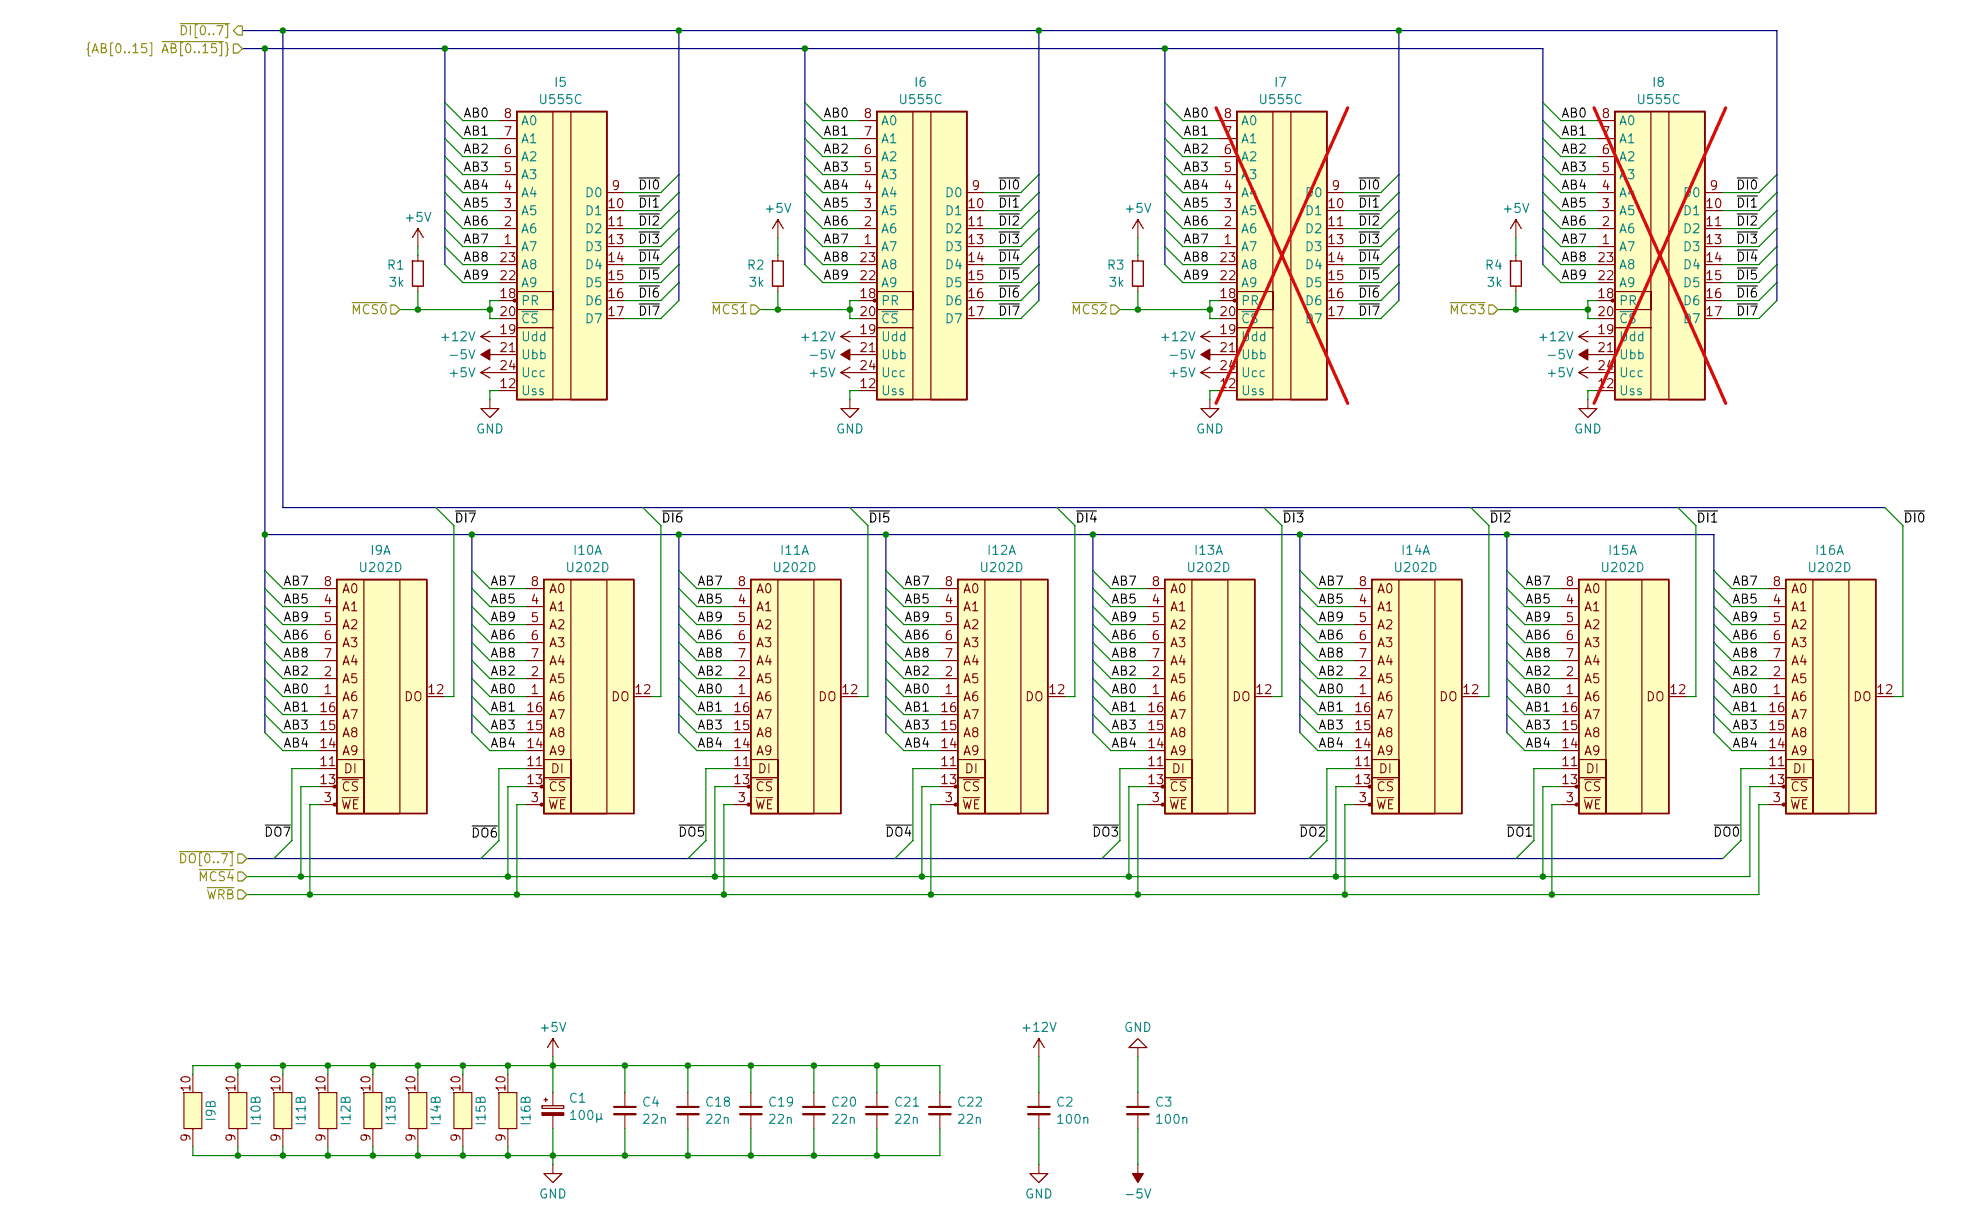
[picture p8: schematic mem.kicad_sch]

Parts:
C1: 100µ
C2, C3: 100n
C4, C18, C19, C20, C21, C22: 22n
I5, I6: U555C
I7, I8: U555C; not fitted
I9, I10, I11, I12, I13, I14, I15, I16: U202D
R1, R2, R3, R4: 3k

Connections:
+5V: C1.1, C4.1, C18.1, C19.1, C20.1, C21.1, C22.1, I5.24 (Ucc), I6.24 (Ucc), I7.24 (Ucc), I8.24 (Ucc), I9.10 (Udd), I10.10 (Udd), I11.10 (Udd), I12.10 (Udd), I13.10 (Udd), I14.10 (Udd), I15.10 (Udd), I16.10 (Udd), R1.1, R2.1, R3.1, R4.1
+12V: C2.1, I5.19 (Udd), I6.19 (Udd), I7.19 (Udd), I8.19 (Udd)
-5V: C3.2, I5.21 (Ubb), I6.21 (Ubb), I7.21 (Ubb), I8.21 (Ubb)
AB0: I5.8 (A0), I6.8 (A0), I7.8 (A0), I8.8 (A0), I9.1 (A6), I10.1 (A6), I11.1 (A6), I12.1 (A6), I13.1 (A6), I14.1 (A6), I15.1 (A6), I16.1 (A6)
AB1: I5.7 (A1), I6.7 (A1), I7.7 (A1), I8.7 (A1), I9.16 (A7), I10.16 (A7), I11.16 (A7), I12.16 (A7), I13.16 (A7), I14.16 (A7), I15.16 (A7), I16.16 (A7)
AB2: I5.6 (A2), I6.6 (A2), I7.6 (A2), I8.6 (A2), I9.2 (A5), I10.2 (A5), I11.2 (A5), I12.2 (A5), I13.2 (A5), I14.2 (A5), I15.2 (A5), I16.2 (A5)
AB3: I5.5 (A3), I6.5 (A3), I7.5 (A3), I8.5 (A3), I9.15 (A8), I10.15 (A8), I11.15 (A8), I12.15 (A8), I13.15 (A8), I14.15 (A8), I15.15 (A8), I16.15 (A8)
AB4: I5.4 (A4), I6.4 (A4), I7.4 (A4), I8.4 (A4), I9.14 (A9), I10.14 (A9), I11.14 (A9), I12.14 (A9), I13.14 (A9), I14.14 (A9), I15.14 (A9), I16.14 (A9)
AB5: I5.3 (A5), I6.3 (A5), I7.3 (A5), I8.3 (A5), I9.4 (A1), I10.4 (A1), I11.4 (A1), I12.4 (A1), I13.4 (A1), I14.4 (A1), I15.4 (A1), I16.4 (A1)
AB6: I5.2 (A6), I6.2 (A6), I7.2 (A6), I8.2 (A6), I9.6 (A3), I10.6 (A3), I11.6 (A3), I12.6 (A3), I13.6 (A3), I14.6 (A3), I15.6 (A3), I16.6 (A3)
AB7: I5.1 (A7), I6.1 (A7), I7.1 (A7), I8.1 (A7), I9.8 (A0), I10.8 (A0), I11.8 (A0), I12.8 (A0), I13.8 (A0), I14.8 (A0), I15.8 (A0), I16.8 (A0)
AB8: I5.23 (A8), I6.23 (A8), I7.23 (A8), I8.23 (A8), I9.7 (A4), I10.7 (A4), I11.7 (A4), I12.7 (A4), I13.7 (A4), I14.7 (A4), I15.7 (A4), I16.7 (A4)
AB9: I5.22 (A9), I6.22 (A9), I7.22 (A9), I8.22 (A9), I9.5 (A2), I10.5 (A2), I11.5 (A2), I12.5 (A2), I13.5 (A2), I14.5 (A2), I15.5 (A2), I16.5 (A2)
GND: C1.2, C2.2, C3.1, C4.2, C18.2, C19.2, C20.2, C21.2, C22.2, I5.12 (Uss), I6.12 (Uss), I7.12 (Uss), I8.12 (Uss), I9.9 (Uss), I10.9 (Uss), I11.9 (Uss), I12.9 (Uss), I13.9 (Uss), I14.9 (Uss), I15.9 (Uss), I16.9 (Uss)
~DI0: I5.9 (D0), I6.9 (D0), I7.9 (D0), I8.9 (D0), I16.12 (DO)
~DI1: I5.10 (D1), I6.10 (D1), I7.10 (D1), I8.10 (D1), I15.12 (DO)
~DI2: I5.11 (D2), I6.11 (D2), I7.11 (D2), I8.11 (D2), I14.12 (DO)
~DI3: I5.13 (D3), I6.13 (D3), I7.13 (D3), I8.13 (D3), I13.12 (DO)
~DI4: I5.14 (D4), I6.14 (D4), I7.14 (D4), I8.14 (D4), I12.12 (DO)
~DI5: I5.15 (D5), I6.15 (D5), I7.15 (D5), I8.15 (D5), I11.12 (DO)
~DI6: I5.16 (D6), I6.16 (D6), I7.16 (D6), I8.16 (D6), I10.12 (DO)
~DI7: I5.17 (D7), I6.17 (D7), I7.17 (D7), I8.17 (D7), I9.12 (DO)
~DO0: I16.11 (DI)
~DO1: I15.11 (DI)
~DO2: I14.11 (DI)
~DO3: I13.11 (DI)
~DO4: I12.11 (DI)
~DO5: I11.11 (DI)
~DO6: I10.11 (DI)
~DO7: I9.11 (DI)
~MCS0: I5.18 (PR), I5.20 (~CS), R1.2
~MCS1: I6.18 (PR), I6.20 (~CS), R2.2
~MCS2: I7.18 (PR), I7.20 (~CS), R3.2
~MCS3: I8.18 (PR), I8.20 (~CS), R4.2
~MCS4: I9.13 (~CS), I10.13 (~CS), I11.13 (~CS), I12.13 (~CS), I13.13 (~CS), I14.13 (~CS), I15.13 (~CS), I16.13 (~CS)
~WRB: I9.3 (~WE), I10.3 (~WE), I11.3 (~WE), I12.3 (~WE), I13.3 (~WE), I14.3 (~WE), I15.3 (~WE), I16.3 (~WE)
