hamarituc/poly880-ng/original/schaltung/periph.kicad_sch

## KiCad design original/schaltung/periph.kicad_sch (2026-01-04)

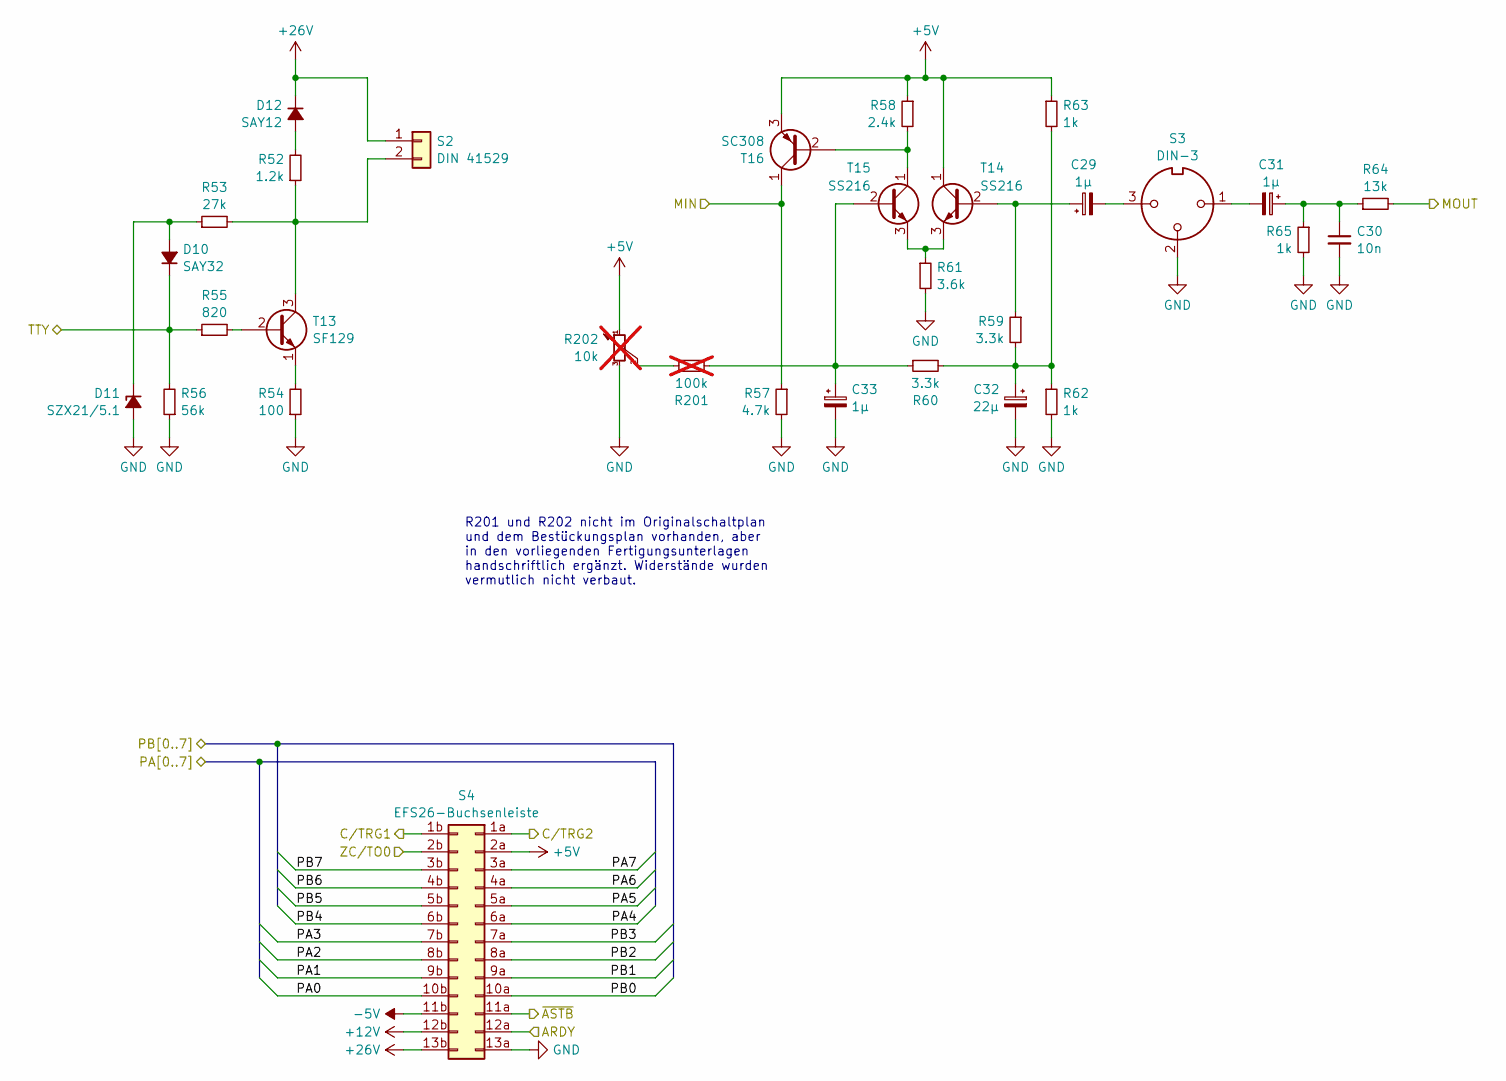
[picture p9: schematic periph.kicad_sch]

Parts:
C29, C31, C33: 1µ
C30: 10n
C32: 22µ
D10: SAY32; D_E-Line_01x02_P2.5mm_Vertical_KA
D11: SZX21/5.1; D_E-Line_01x02_P2.5mm_Vertical_KA
D12: SAY12
R52: 1.2k
R53: 27k
R54: 100
R55: 820
R56: 56k
R57: 4.7k
R58: 2.4k
R59, R60: 3.3k
R61: 3.6k
R62, R63, R65: 1k
R64: 13k
R201: 100k; not fitted
R202: 10k; not fitted
S2: DIN 41529
S3: DIN-3
S4: EFS26-Buchsenleiste
T13: SF129; TO-39-3
T14, T15: SS216; T_E-Line_P2.5mm_Vertical
T16: SC308; T_E-Line_P2.5mm_Vertical

Connections:
+5V: R58.1, R63.1, R202.1, S4.2a, T14.1 (C), T16.3 (E)
+12V: S4.12b
+26V: D12.1 (K), S2.1, S4.13b
-5V: S4.11b
ARDY: S4.12a
C/TRG1: S4.1b
C/TRG2: S4.1a
GND: C30.2, C32.2, C33.2, D11.2 (A), R54.1, R56.1, R57.2, R61.2, R62.2, R65.2, R202.3, S3.2, S4.13a
MIN: R57.1, T16.1 (C)
MOUT: R64.2
unnamed: C29.1, R59.1, T14.2 (B)
unnamed: C29.2, S3.3
unnamed: C30.1, C31.1, R64.1, R65.1
unnamed: C31.2, S3.1
unnamed: C32.1, R59.2, R60.2, R62.1, R63.2
unnamed: C33.1, R60.1, R201.2, T15.2 (B)
unnamed: D10.2 (A), D11.1 (K), R53.1
unnamed: D12.2 (A), R52.2
unnamed: R52.1, R53.2, S2.2, T13.3 (C)
unnamed: R54.2, T13.1 (E)
unnamed: R55.2, T13.2 (B)
unnamed: R58.2, T15.1 (C), T16.2 (B)
unnamed: R61.1, T14.3 (E), T15.3 (E)
unnamed: R201.1, R202.2
PA0: S4.10b
PA1: S4.9b
PA2: S4.8b
PA3: S4.7b
PA4: S4.6a
PA5: S4.5a
PA6: S4.4a
PA7: S4.3a
PB0: S4.10a
PB1: S4.9a
PB2: S4.8a
PB3: S4.7a
PB4: S4.6b
PB5: S4.5b
PB6: S4.4b
PB7: S4.3b
TTY: D10.1 (K), R55.1, R56.2
ZC/TO0: S4.2b
~ASTB: S4.11a

Notes on the sheet:
R201 und R202 nicht im Originalschaltplan und dem Bestückungsplan vorhanden, aber in den vorliegenden Fertigungsunterlagen handschriftlich ergänzt. Widerstände wurden vermutlich nicht verbaut.
