hamarituc/poly880-ng/original/schaltung/rom.kicad_sch

## KiCad design original/schaltung/rom.kicad_sch (2024-01-25)

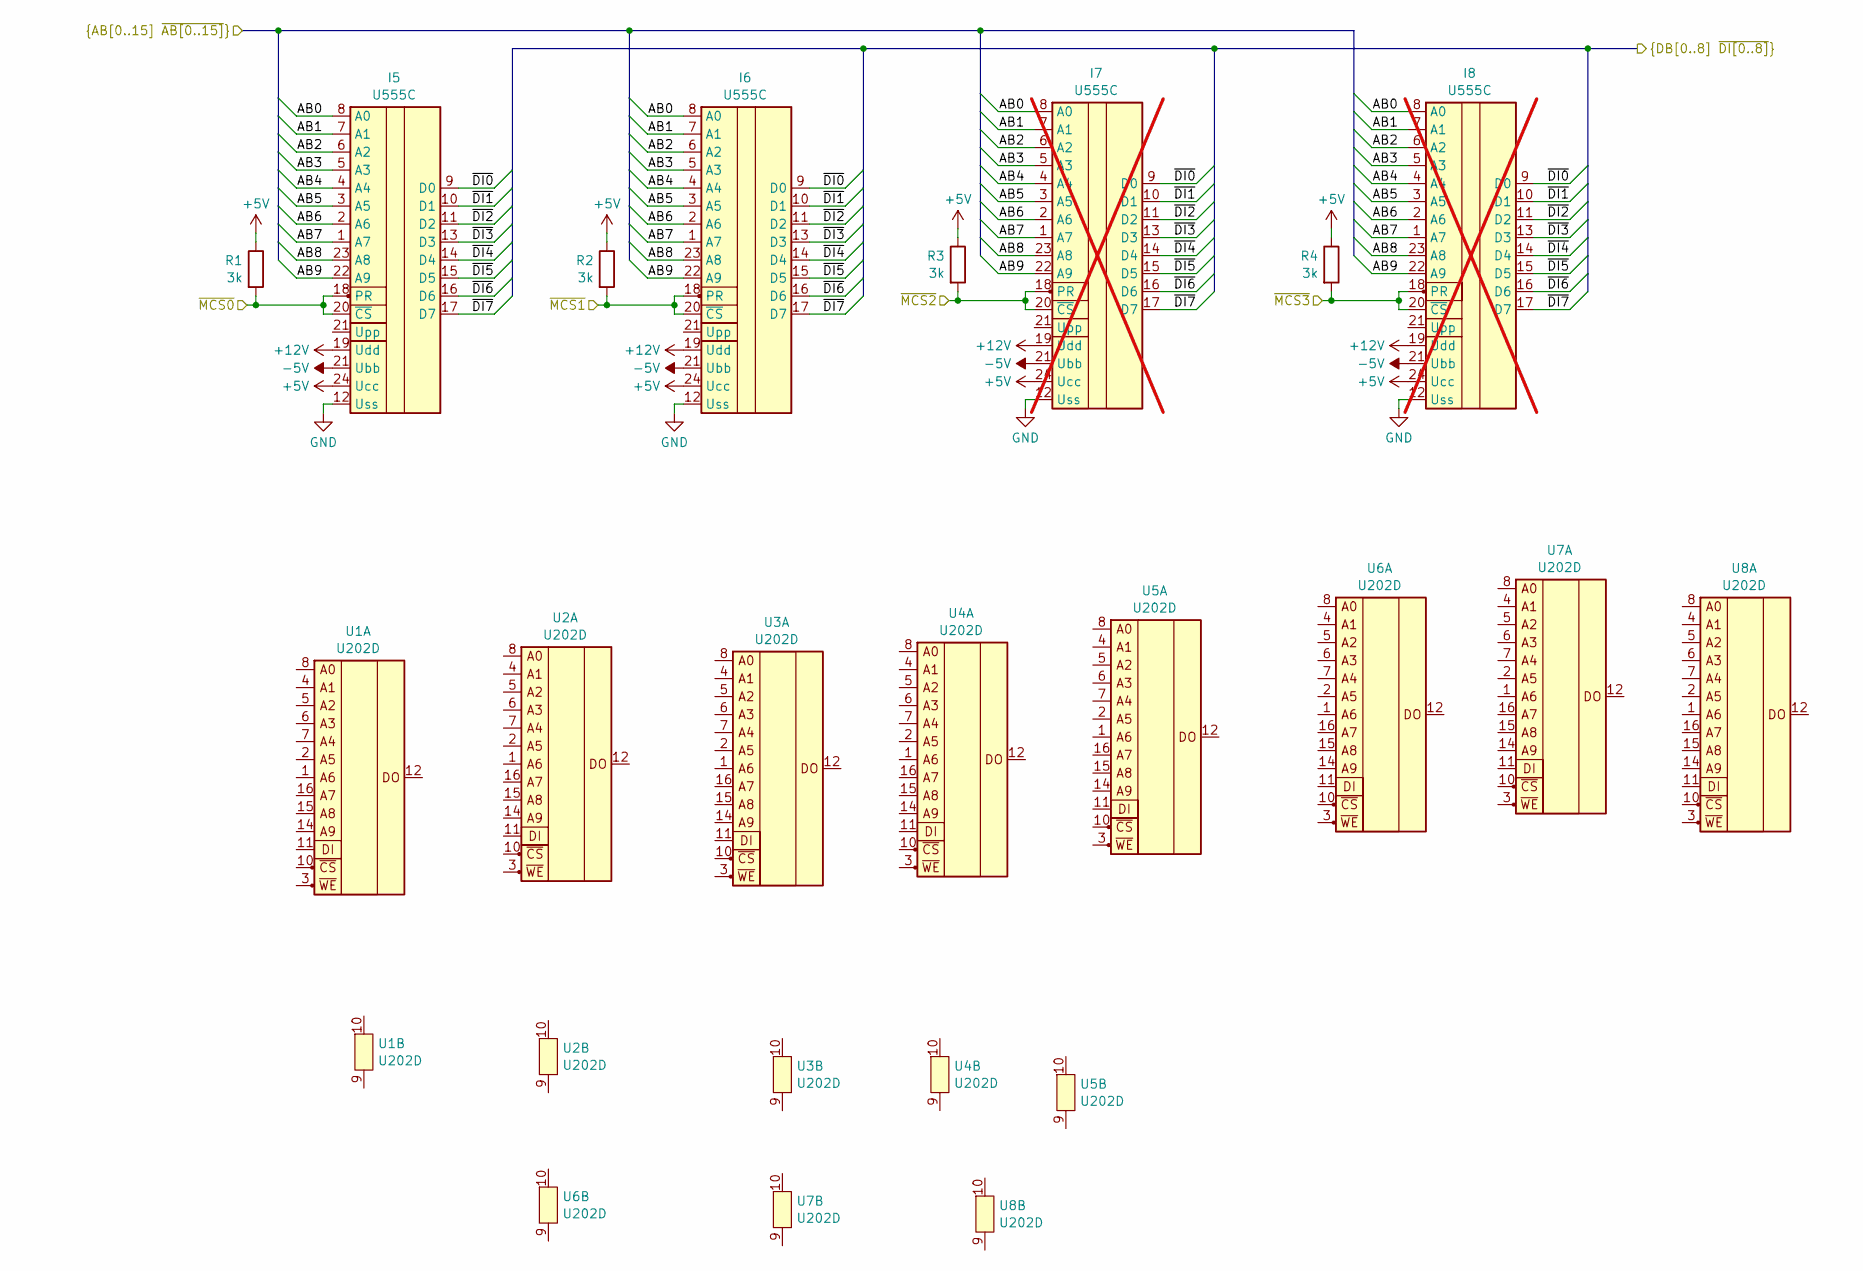
[picture p10: schematic rom.kicad_sch]

Parts:
I5, I6: U555C
I7, I8: U555C; not fitted
R1, R2, R3, R4: 3k
U1, U2, U3, U4, U5, U6, U7, U8: U202D

Connections:
+5V: I5.24 (Ucc), I6.24 (Ucc), I7.24 (Ucc), I8.24 (Ucc), R1.1, R2.1, R3.1, R4.1
+12V: I5.19 (Udd), I6.19 (Udd), I7.19 (Udd), I8.19 (Udd)
-5V: I5.21 (Ubb), I6.21 (Ubb), I7.21 (Ubb), I8.21 (Ubb)
AB0: I5.8 (A0), I6.8 (A0), I7.8 (A0), I8.8 (A0)
AB1: I5.7 (A1), I6.7 (A1), I7.7 (A1), I8.7 (A1)
AB2: I5.6 (A2), I6.6 (A2), I7.6 (A2), I8.6 (A2)
AB3: I5.5 (A3), I6.5 (A3), I7.5 (A3), I8.5 (A3)
AB4: I5.4 (A4), I6.4 (A4), I7.4 (A4), I8.4 (A4)
AB5: I5.3 (A5), I6.3 (A5), I7.3 (A5), I8.3 (A5)
AB6: I5.2 (A6), I6.2 (A6), I7.2 (A6), I8.2 (A6)
AB7: I5.1 (A7), I6.1 (A7), I7.1 (A7), I8.1 (A7)
AB8: I5.23 (A8), I6.23 (A8), I7.23 (A8), I8.23 (A8)
AB9: I5.22 (A9), I6.22 (A9), I7.22 (A9), I8.22 (A9)
GND: I5.12 (Uss), I6.12 (Uss), I7.12 (Uss), I8.12 (Uss)
~DI0: I5.9 (D0), I6.9 (D0), I7.9 (D0), I8.9 (D0)
~DI1: I5.10 (D1), I6.10 (D1), I7.10 (D1), I8.10 (D1)
~DI2: I5.11 (D2), I6.11 (D2), I7.11 (D2), I8.11 (D2)
~DI3: I5.13 (D3), I6.13 (D3), I7.13 (D3), I8.13 (D3)
~DI4: I5.14 (D4), I6.14 (D4), I7.14 (D4), I8.14 (D4)
~DI5: I5.15 (D5), I6.15 (D5), I7.15 (D5), I8.15 (D5)
~DI6: I5.16 (D6), I6.16 (D6), I7.16 (D6), I8.16 (D6)
~DI7: I5.17 (D7), I6.17 (D7), I7.17 (D7), I8.17 (D7)
~MCS0: I5.18 (PR), I5.20 (~CS), R1.2
~MCS1: I6.18 (PR), I6.20 (~CS), R2.2
~MCS2: I7.18 (PR), I7.20 (~CS), R3.2
~MCS3: I8.18 (PR), I8.20 (~CS), R4.2
