hamarituc/poly880-ng/(commit log)

2024-01-25 Originalschaltplan Polycomputer 880
    [addr.kicad_sch, bus.kicad_sch, clock.kicad_sch, conn.kicad_sch, cpu.kicad_sch, disp.kicad_sch, io.kicad_sch, keyb.kicad_sch]
2024-01-28 Verzeichnisstruktur reorganisiert
    [addr.kicad_sch, bus.kicad_sch, clock.kicad_sch, conn.kicad_sch, cpu.kicad_sch, disp.kicad_sch, io.kicad_sch, keyb.kicad_sch]
2024-01-29 I/O-Adressraum auf 8 Bit gekürzt
    [addr.kicad_sch]
2024-01-29 Ausrichtung der ROM-Speicher im Binär-Image
2024-01-29 Hinweise zur I/O-Adressdekodierung im Schaltplan
    [addr.kicad_sch, bus.kicad_sch, clock.kicad_sch, disp.kicad_sch, periph.kicad_sch]
2024-01-29 Beschreibung der Bus-Treiber
2024-01-30 Anpassung Übersichtsschaltbild
    [pc880.kicad_sch]
2024-02-11 Übersichtlicheres Schaltplanlayout der Tastaturmatrix
    [keyb.kicad_sch]
2024-02-11 Redaktionelle Änderungen
    [keyb.kicad_sch]
2025-01-03 Schönheitskorrekturen Schaltplan
    [addr.kicad_sch, bus.kicad_sch, clock.kicad_sch, conn.kicad_sch, cpu.kicad_sch, disp.kicad_sch, io.kicad_sch, keyb.kicad_sch]
2026-01-04 Typo Schaltplan
    [addr.kicad_sch, bus.kicad_sch, clock.kicad_sch, conn.kicad_sch, cpu.kicad_sch, disp.kicad_sch, io.kicad_sch, keyb.kicad_sch]
